szl0834/DIY-Optical-Spectrometer/FYP_Code/FYP/Data/a.jpg

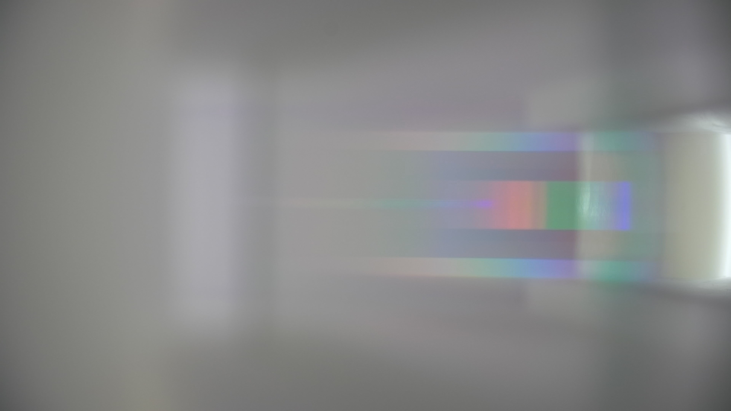
FYP_Code/FYP/Data/a.jpg
