szl0834/DIY-Optical-Spectrometer/README.md

# DIY-Optical-Spectrometer
A low cost high quality DIY optical spectrometer solution
