szl0834/DIY-Optical-Spectrometer/Presentation/Pre_Presentation.pptx

UESTC ID:
GUID:

## USB Spectrometer

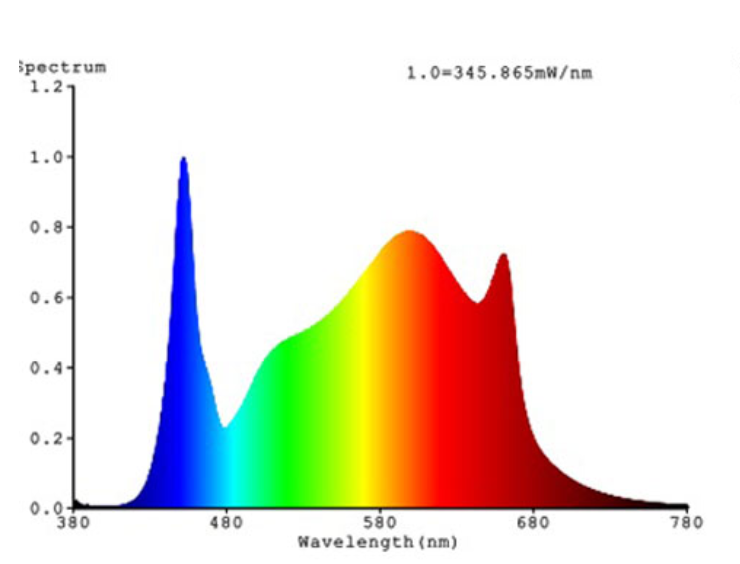
[picture p2: figure]
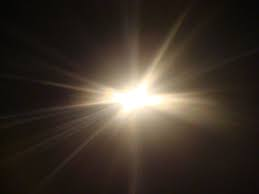
[picture p3: figure]

FT

## Structure of the spectrometer

Diffraction Grating

Source

Single Slit

USB Camera

## Diffraction Grating

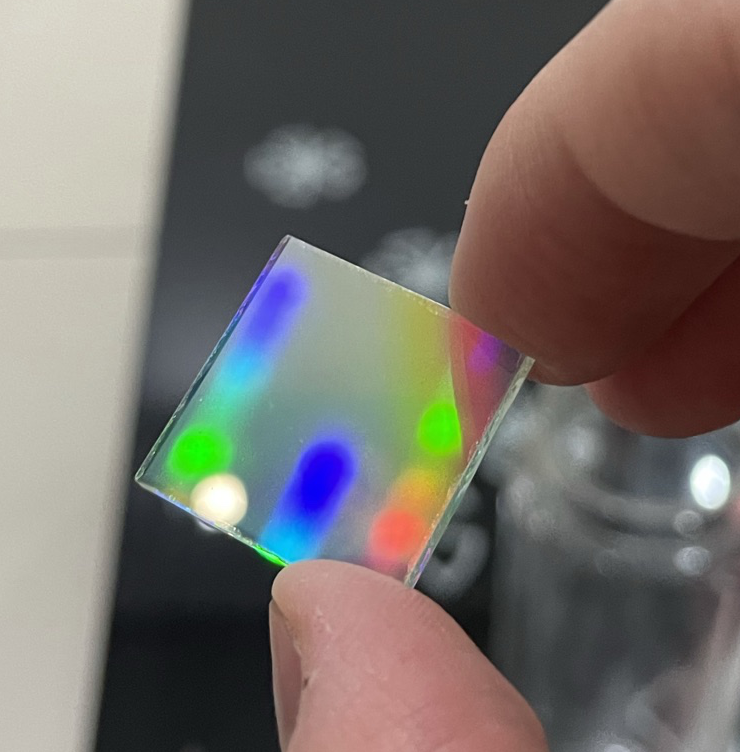
[picture p4: figure]
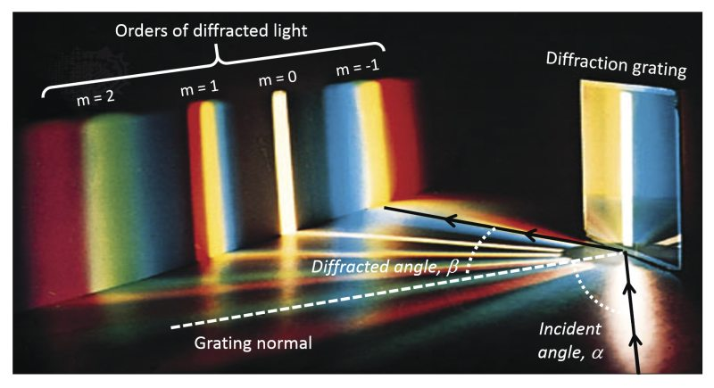
[picture p5: figure]
Diffraction Grating Physics
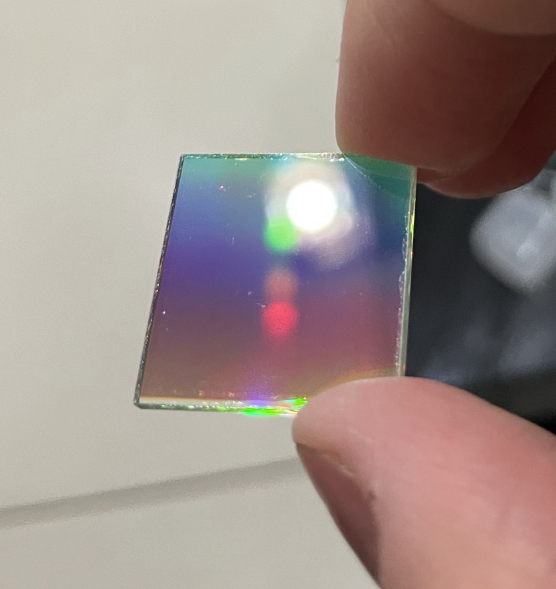
[picture p6: figure]

## Diffraction Grating

Combination of multi-split interference and single-split diffraction

d(sin(θ_i )−sin(θ_m ))=mλ

θ_m =arcsin(sin(θ_i )−(mλ)/d)

## Hardware Demo

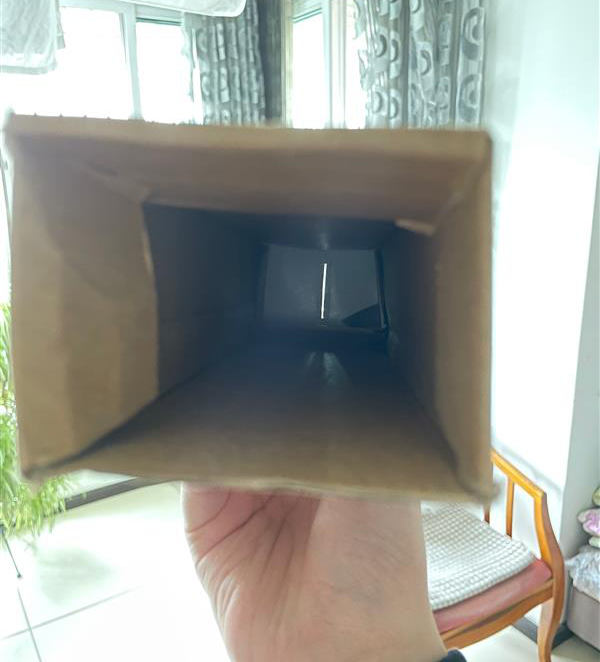
[picture p7: figure]
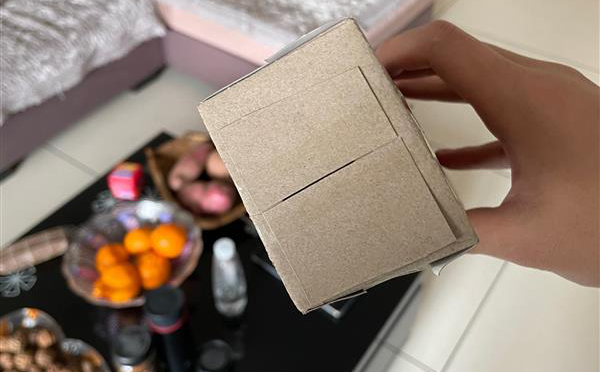
[picture p8: figure]
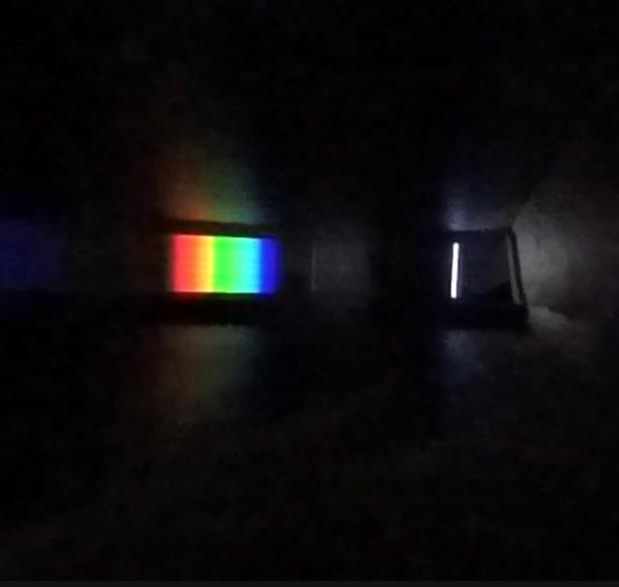
[picture p9: figure]
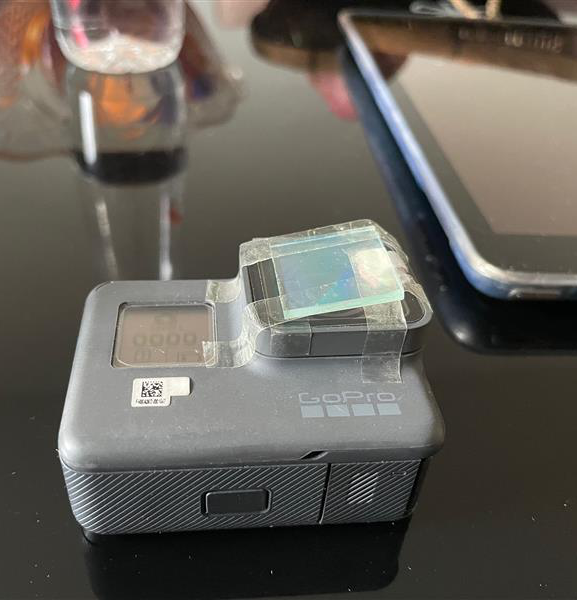
[picture p10: figure]

## Software Demo

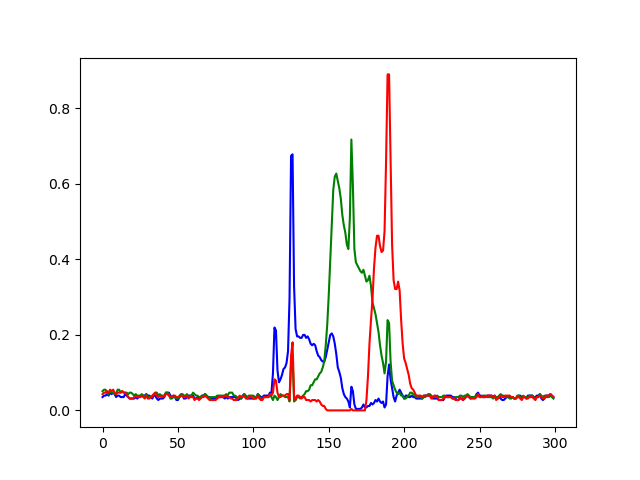
[picture p11: figure]

Using following open-source tools

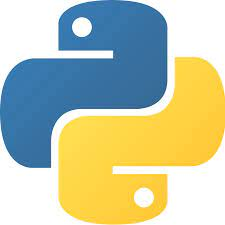
[picture p12: figure]
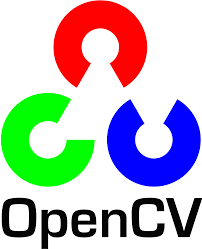
[picture p13: figure]
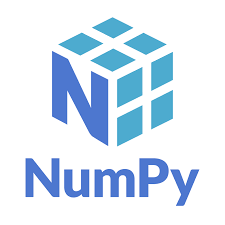
[picture p14: figure]
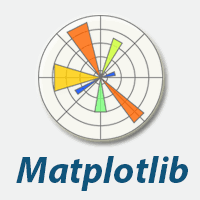
[picture p15: figure]

## Luminance Calibration

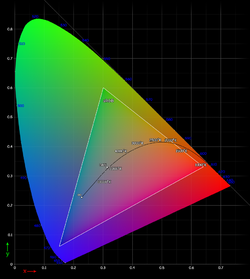
[picture p16: figure]
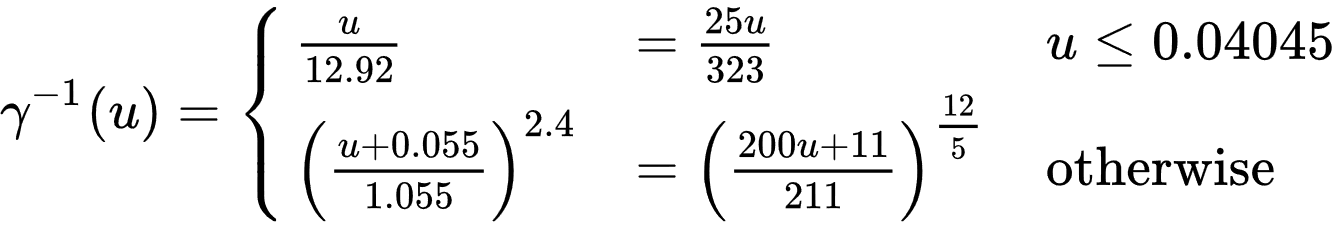
[picture p17: figure]

Where u is RGB in SRGB

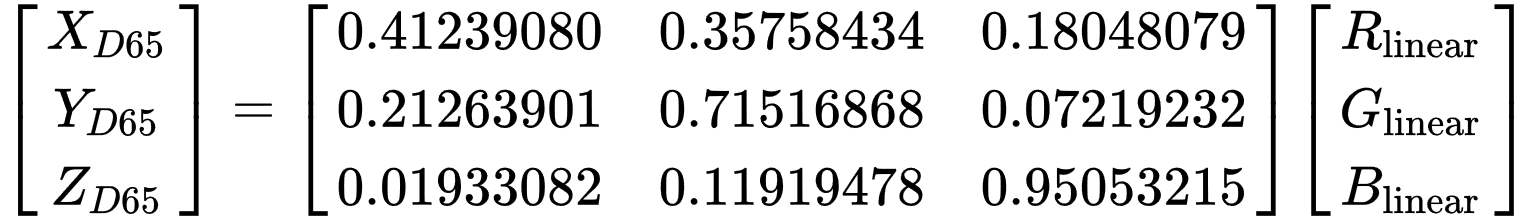
[picture p18: figure]

The Value Y is the relatively luminance

## Luminance Calibration

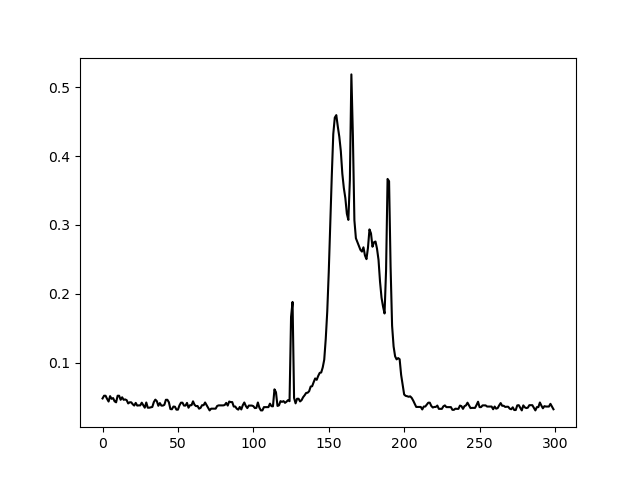
[picture p19: figure]

## Work to be done...

1. Mapping the X-axis to wavelength
2. Made an easy-to-use GUI
