szl0834/DIY-Optical-Spectrometer/Presentation/UESTC4006P_Presentation.pdf

# USB Spectrometer

Name:
UoG ID:
UESTC ID:

## My Student ID

## Index

- Background
- Hardware Design
- Software Design
- Building
- Demonstration
- Result
- Conclusion

## Background

- Absorption and Emission Spectrum
- Spectroscopy

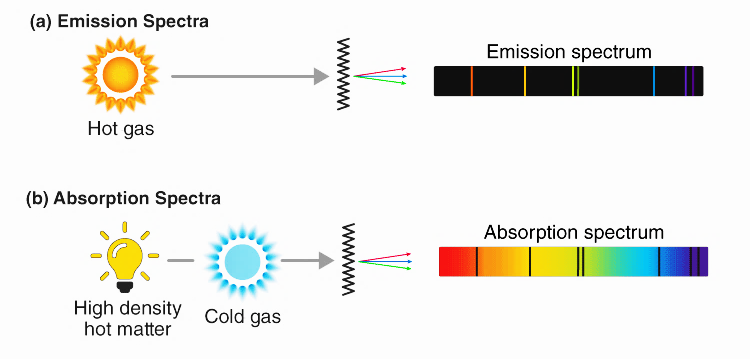
[picture p20: figure]

## Background

- Application
- Spectroscopy

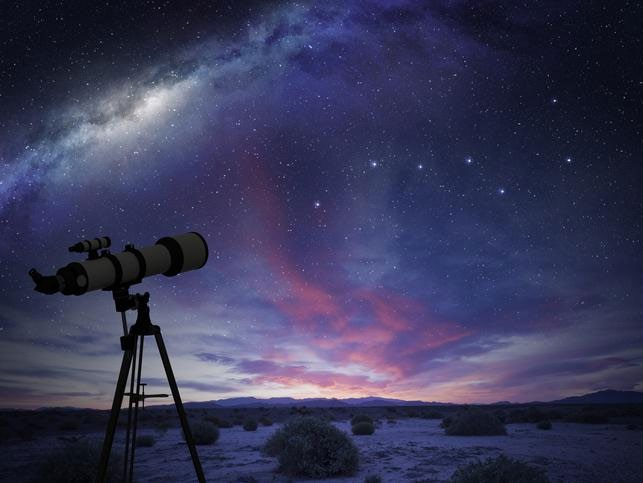
[picture p21: figure]
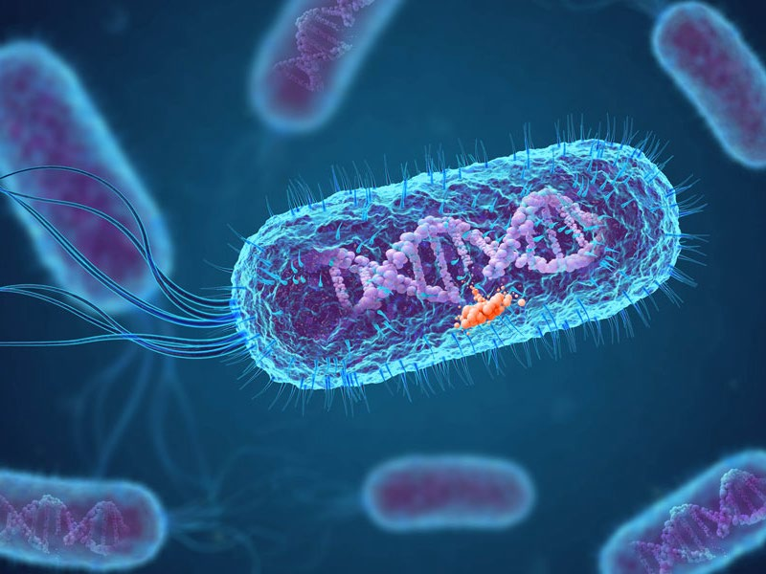
[picture p22: figure]
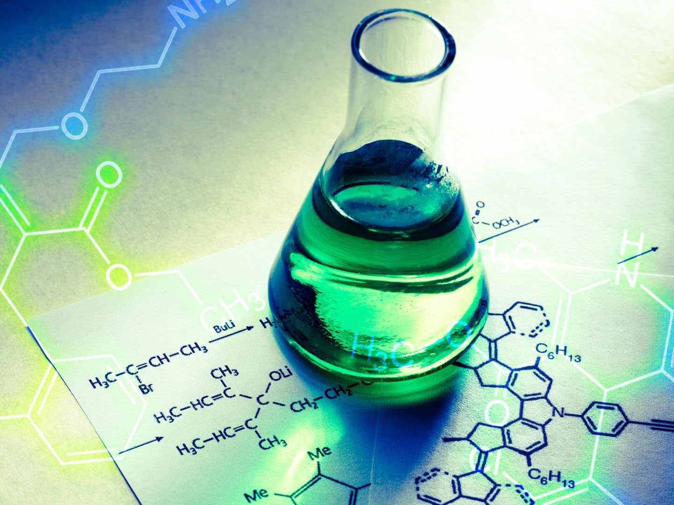
[picture p23: figure]

Chemistry | Astronomy | Biology

## Background

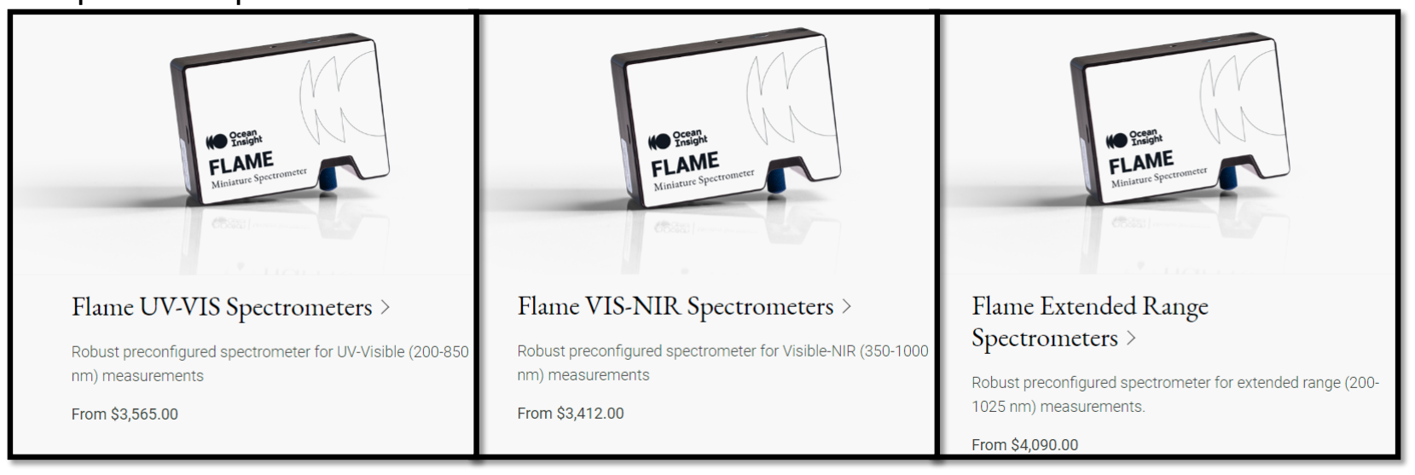
[picture p24: figure]

- Commercial Solution:
Extremely High Price (Thousands of Dollars)
- Optical Spectrometer

## Background

- Current DIY Solution
- Optical Spectrometer
- Low Cost
- Low Resolution
- Low Accuracy
- No Compatible Software

## Background

- Design Goal
- Optical Spectrometer
- Less than 1 nm resolution
- Wide Wavelength Range (400-1000 nm)
- Less than 2000 CNY of cost
- Easy-to-use software
- Opensource all code, 3D models, and other material

## Hardware Design

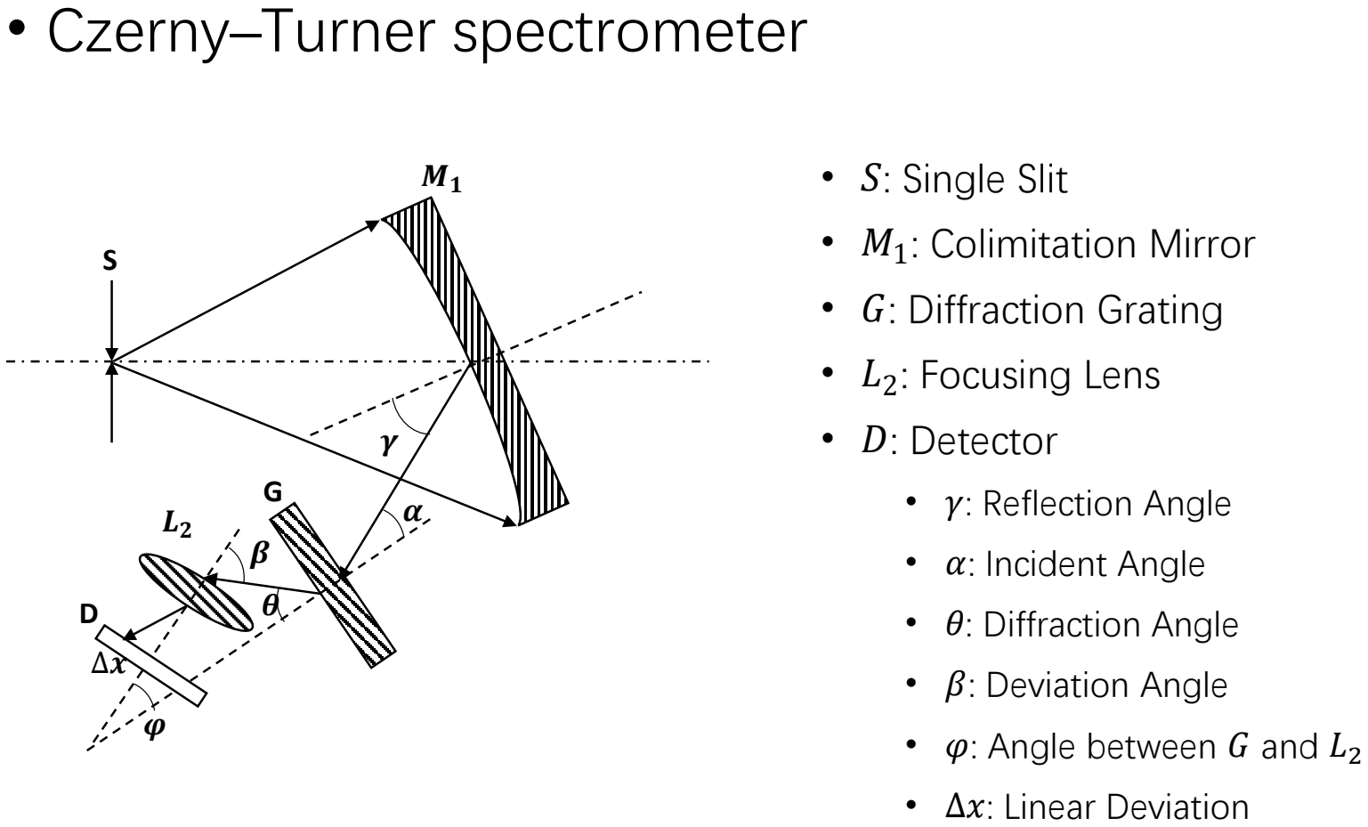
[picture p25: figure]
• Czerny–Turner spectrometer; • SS: Single Slit • MM1: Colimitation Mirror • GG: Diffraction Grating • LL2: Focusing Lens • DD: Detector; • γγ: Reflection Angle • αα: Incident Angle • θθ: Diffraction Angle • ββ: Deviation Angle • φφ: Angle between GG and LL2 • ∆xx: Linear Deviation

## Hardware Design

- Diffraction Grating

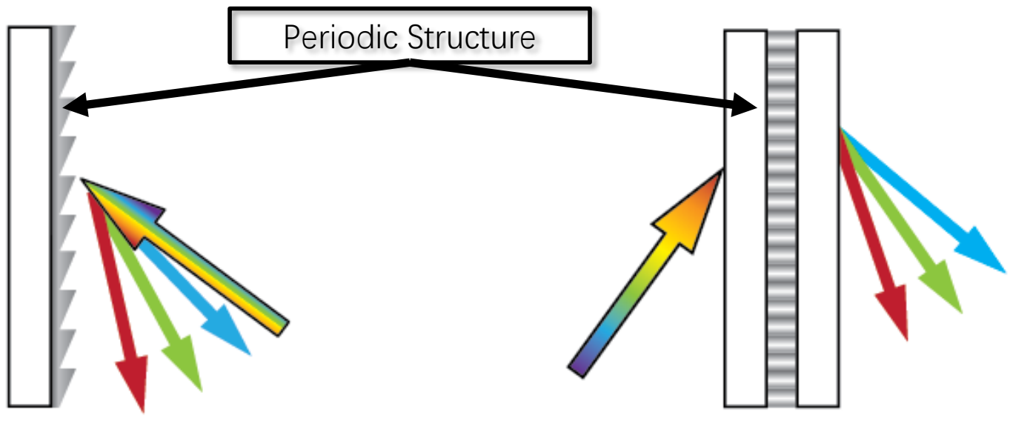
[picture p26: figure]
Periodic Structure

Reflected Grating [1] | Transparent Grating [1]

## Hardware Design

- Diffraction Grating

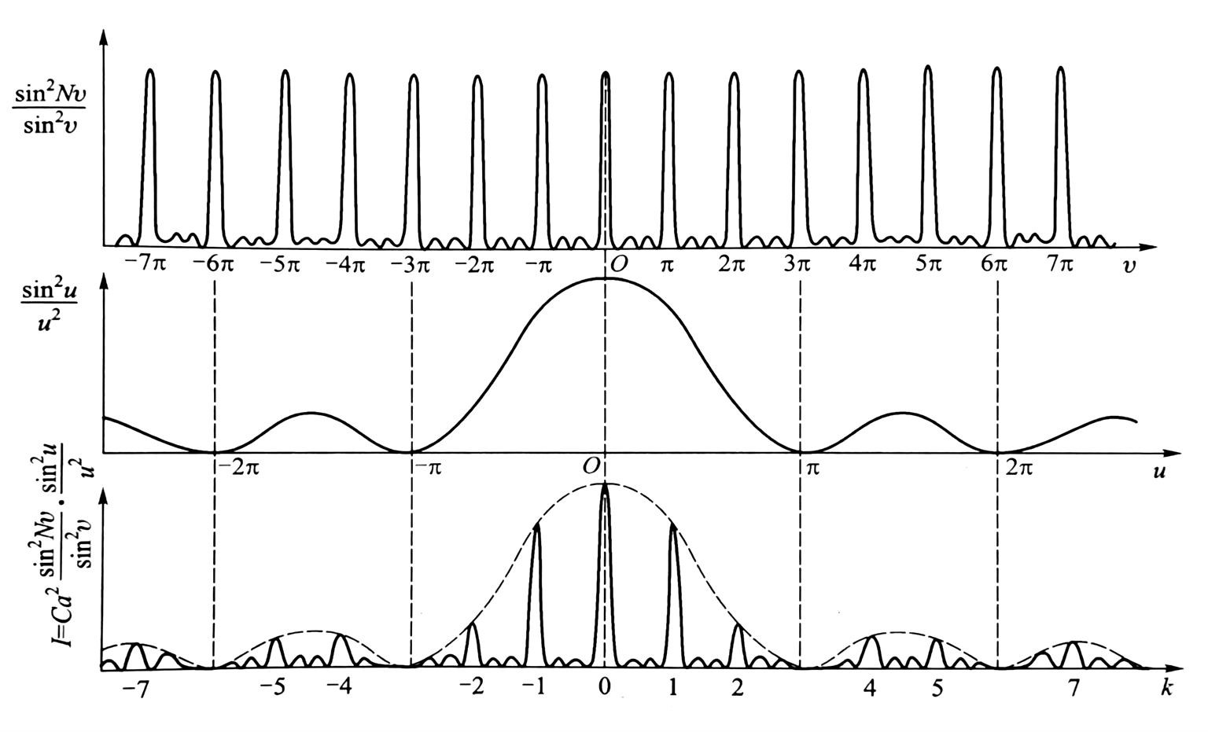
[picture p27: figure]

# II = AA2 = CC′2

# aa2 ssssss2 uu

uu2

# ssssss2 NNNN

ssssss2
Where uu =

# ππππππππππππ

# λλ , and = ππ +bb

λλ .

# Grating Equation: dd ssssss ± ssssss = kkkk

## Hardware Design

- System Resolution
- Imaging resolution caused by the aperture diffraction limit
- Chromatic resolution of the grating
- The width of the slit’s image on the sensor
- Sensor’s physical resolution.

## Hardware Design

- Grating Chromatic Resolution

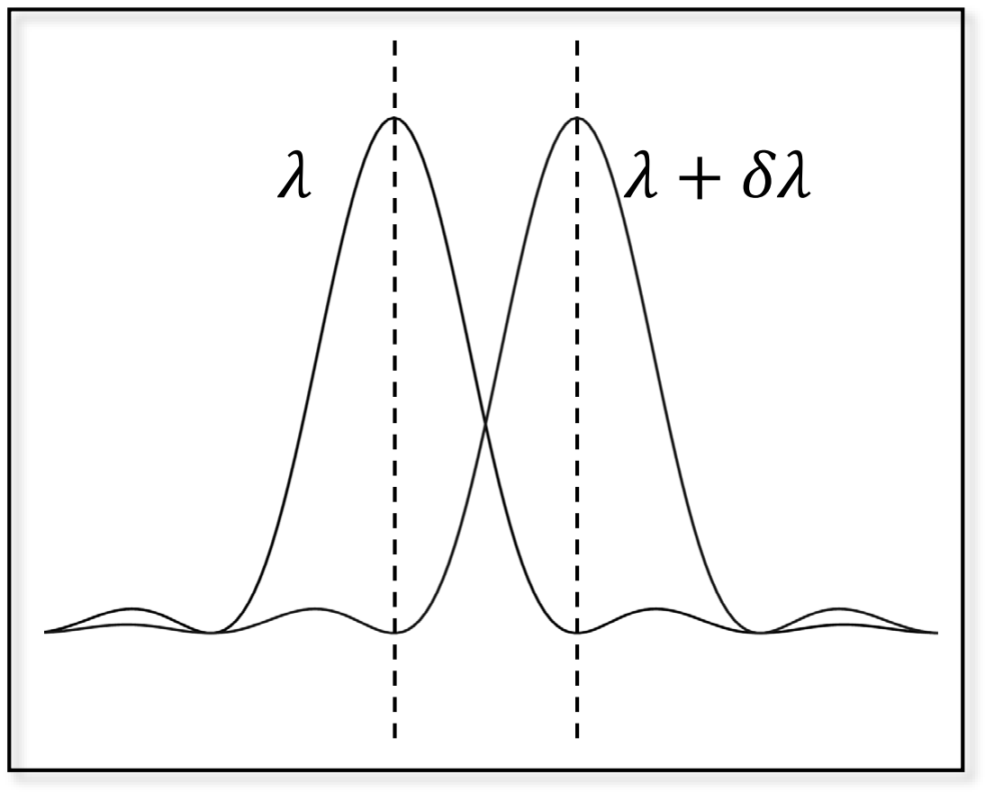
[picture p28: figure]

RR =
δδ

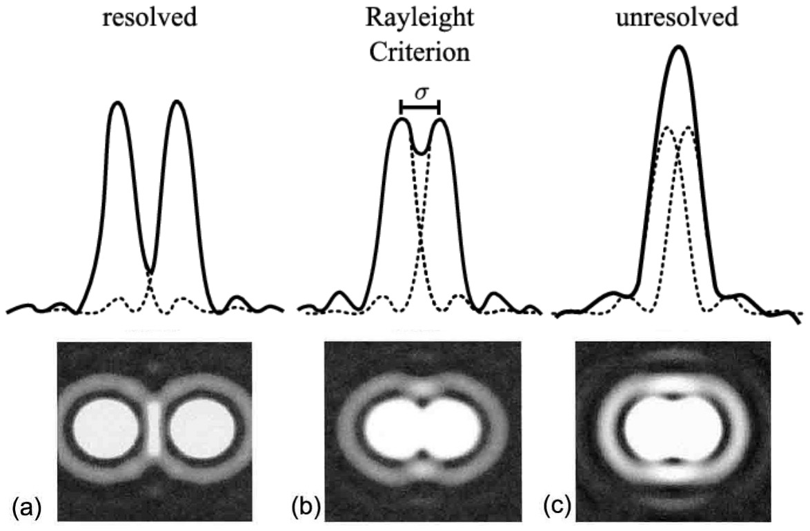
[picture p29: figure]

Demonstration for Rayleigh | = NN − 1 ≈ NN Criterion [4]

## Hardware Design

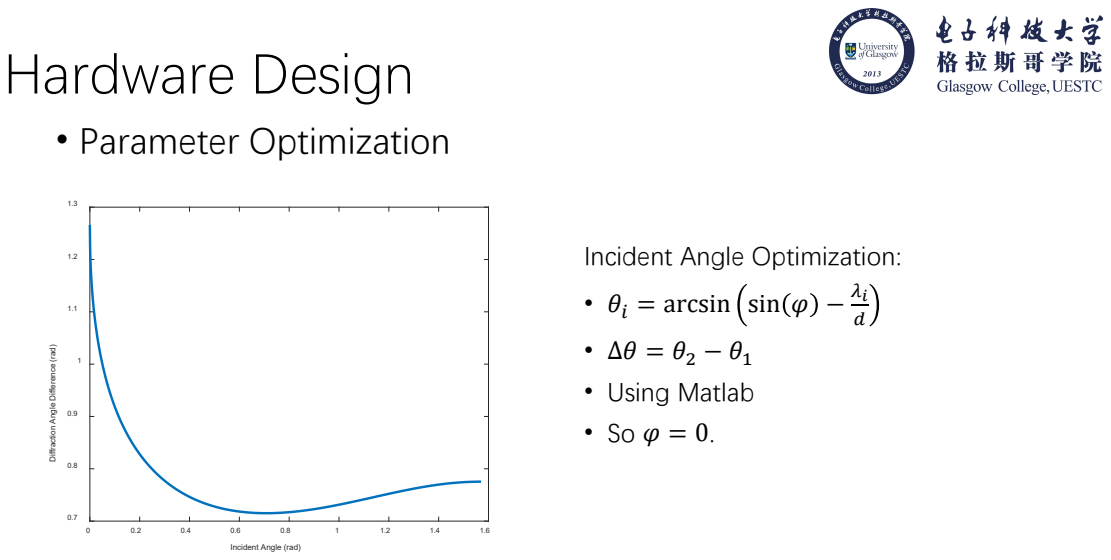
[picture p30: page 14]
• Parameter Optimization

• θθ = arcsin sin φφ − λλii
Incident Angle Optimization:
• Using Matlab

Diffraction Angle Difference (rad)

Incident Angle (rad)

## Hardware Design

- Computer Simulation

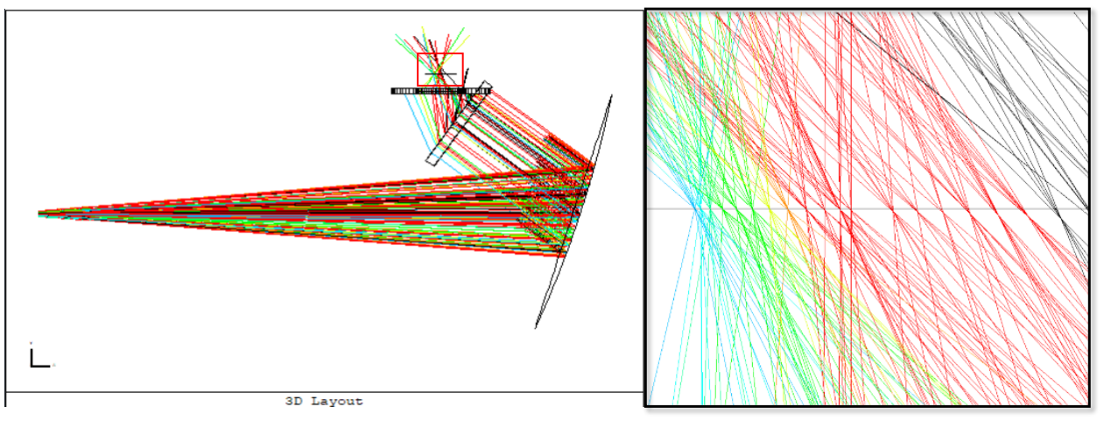
[picture p31: figure]

- Optical Simulation Software: Zemax Optical Studio

## Hardware Design

- Computer Simulation

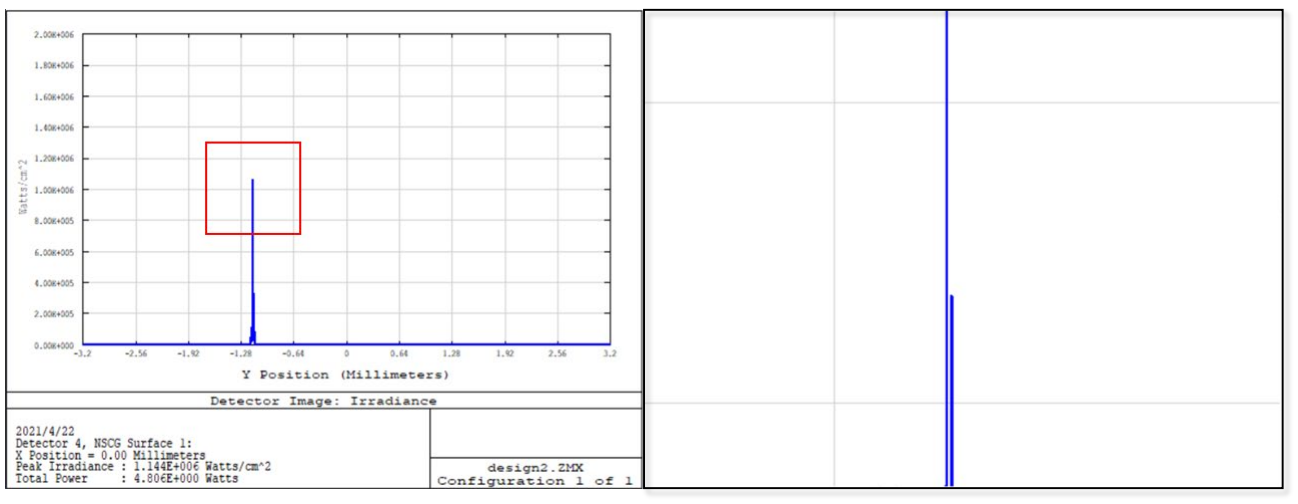
[picture p32: figure]

- D-lines of Sodium (588.9 and 589.5 nm)

# - RRRR RRRR RR RR < 0.6 nn < 1 nn

## Hardware Design

- Computer Simulation

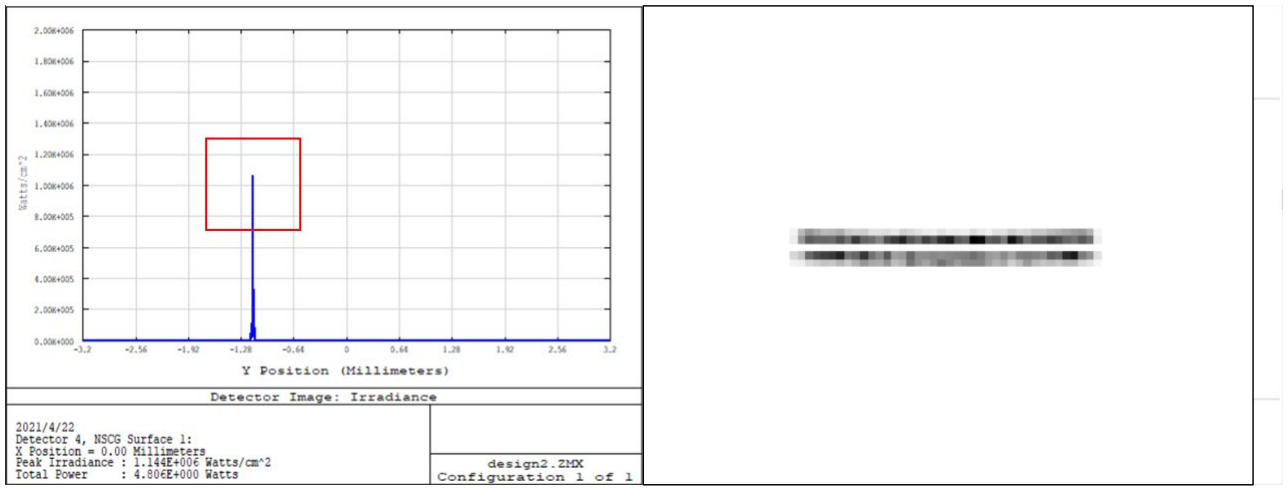
[picture p33: figure]

- D-lines of Sodium (588.9 and 589.5 nm)

## Software Design

- Linear Dispersion

= dd ∗

# ssssss + sin ∆xx

FFLL2

− φφ
kk

Using Imaging Formula and Grating Equation:
∆xx

Spectra Line of
Wavelength Light

## Software Design

- Linear Calibration
Wavelength ( ) | (PPPP) Pixel Position (start from zero)
532 nm | 827
808 nm | 1919
632.8 nm | 1179
650 nm | 1289
3 lasers’ spectrum | Recorded Data

## Software Design

- Color Space

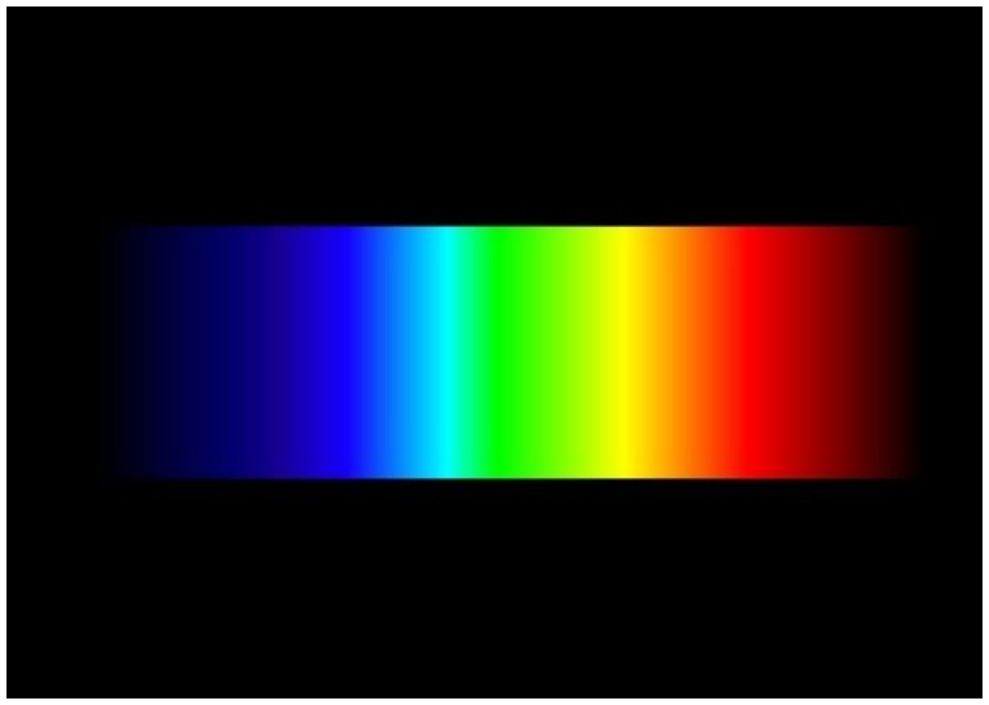
[picture p34: figure]

Continuous Spectrum

Mapping

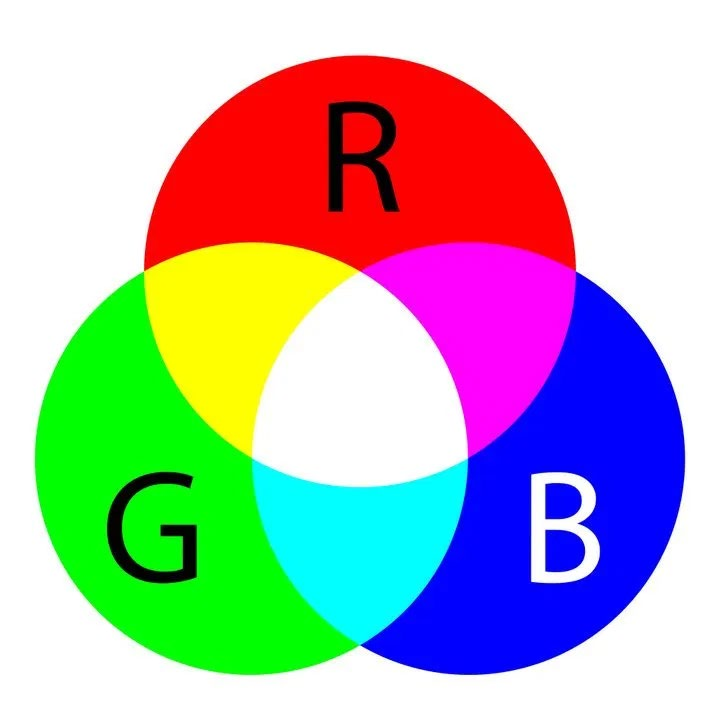
[picture p35: figure]

RGB Color Space

## Software Design

- sRGB Color Space

standard Red Green Blue (sRGB): Design to match perceptions of human eyes

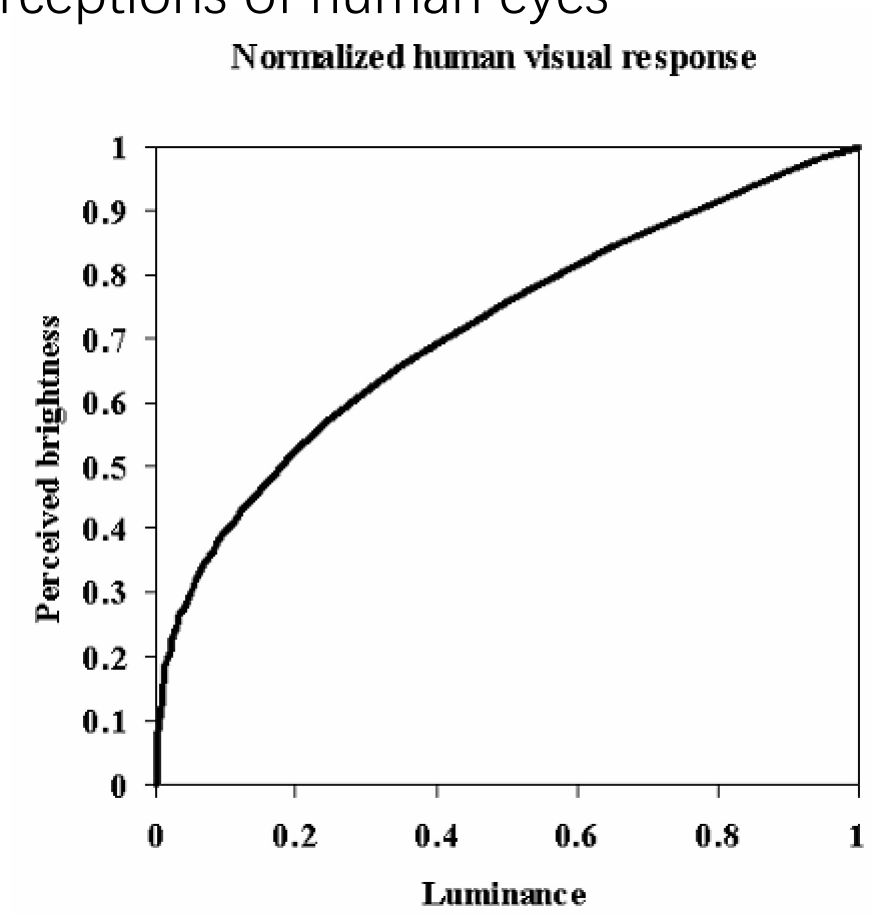
[picture p36: figure]
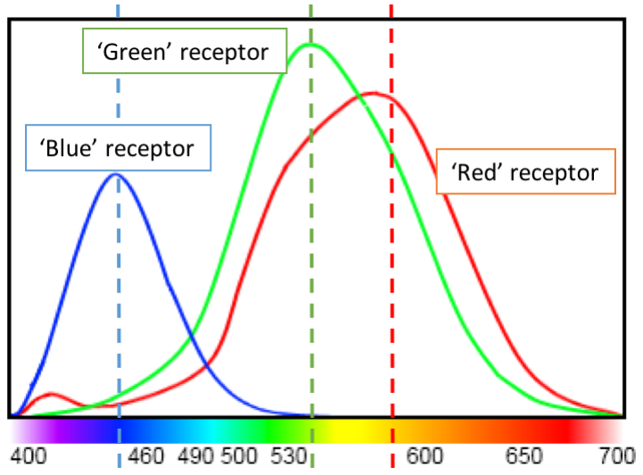
[picture p37: figure]

Sensitivity of Human Eyes [2] | Human Visual Brightness Response [3]

## Software Design

- CIE 1931 Color Space

## γγ−1 uu

25uu
323 , uu ≤ 0.04045
200uu + 11
211

12
5

# ， o oooo

XX
YY
ZZ

=

0.4124 0.3576 0.1805
0.2126 0.7152 0.0722
0.0193 0.1192 0.9505

# Rl l l Gl l l Bl l l

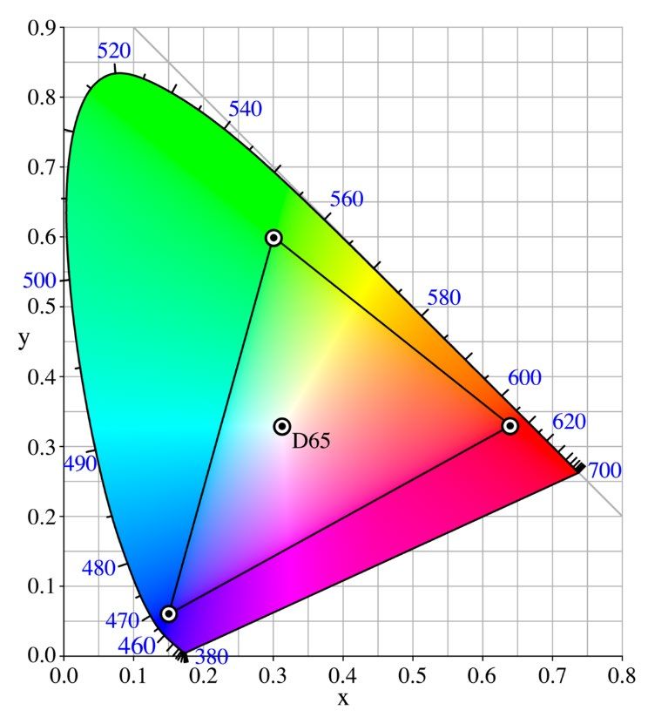
[picture p38: figure]

Chromatic Graph of CIE 1931 [5]

# YY = RRRRRR RR RR LL LL

## Software Design

- Python3 and Opensource Libraries

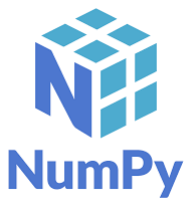
[picture p39: figure]
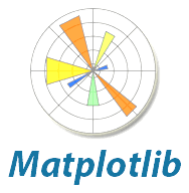
[picture p40: figure]
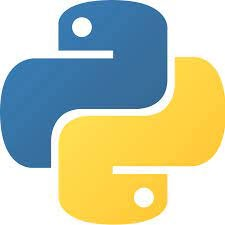
[picture p41: figure]
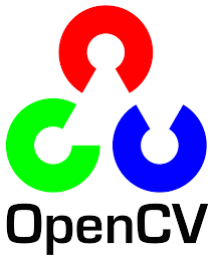
[picture p42: figure]

## Hardware Building

- 3D Modeling

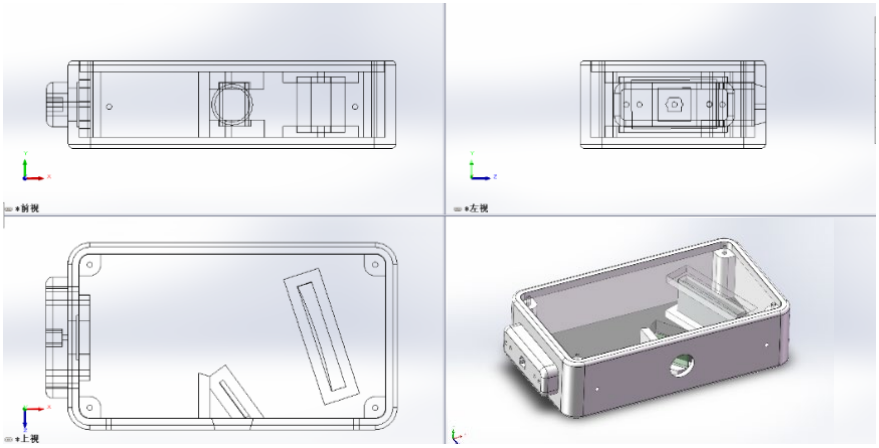
[picture p43: figure]

## Hardware Building

- 3D Printing

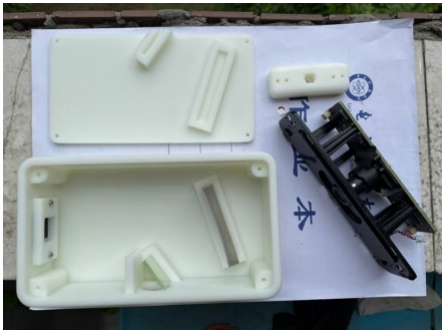
[picture p44: figure]

## Hardware Building

- Assembling

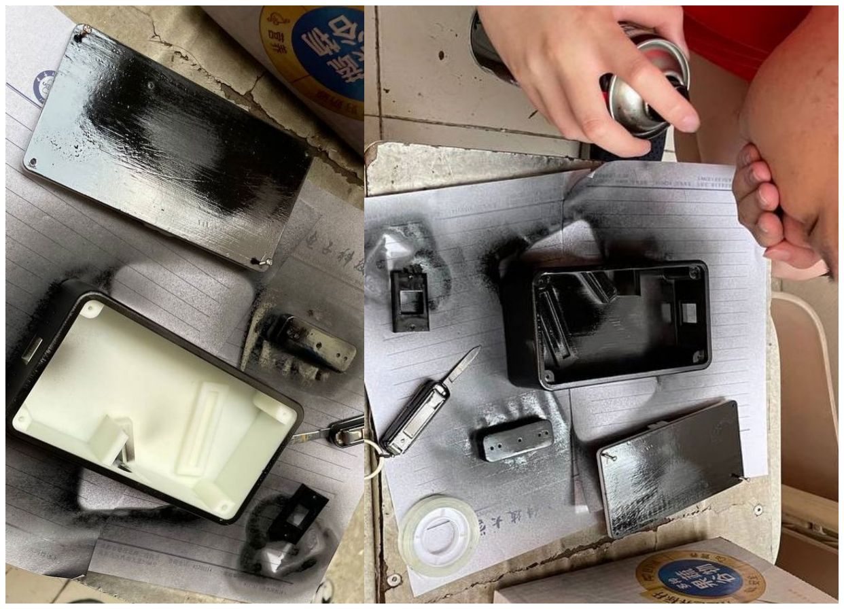
[picture p45: figure]
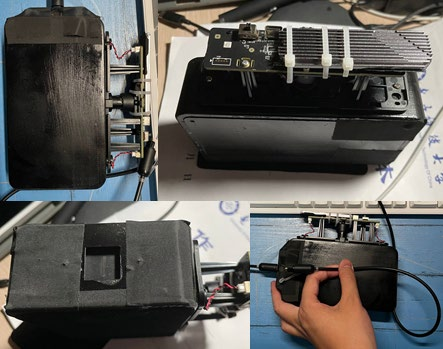
[picture p46: figure]
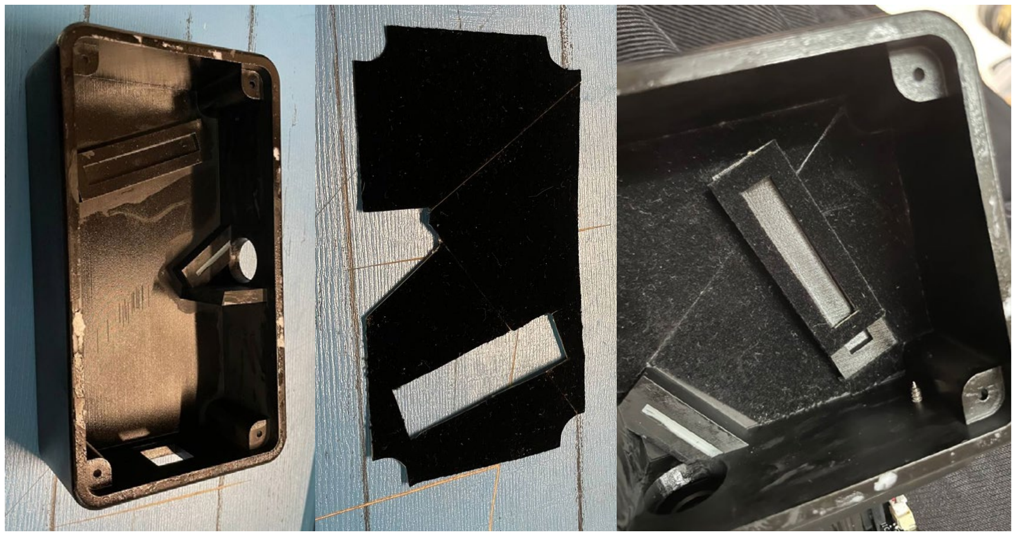
[picture p47: figure]

## Hardware Building

- Total Cost
Name of component | Price with shipping fee (CNY)
Diffraction Grating | 165
Collimator Mirror | 105
Steel Single Slit | 125
Camera | 499
3D Printed Case | 285
Optical Fibre | 20
Lasers | 70
Overall | 1269

## Demonstration

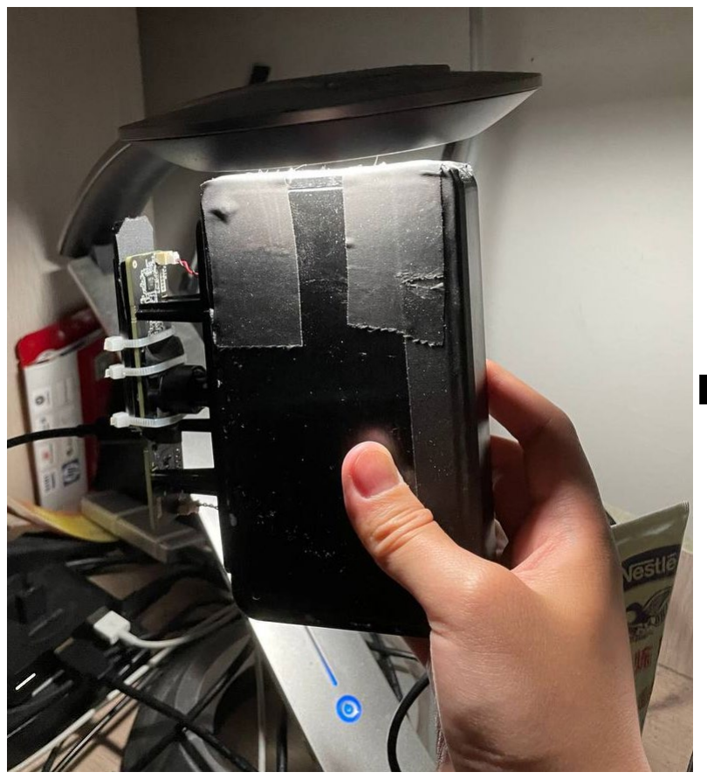
[picture p48: figure]
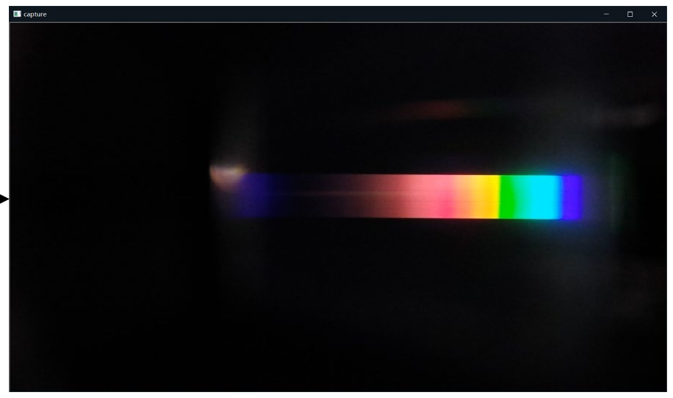
[picture p49: figure]
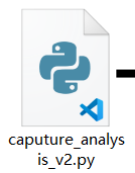
[picture p50: figure]
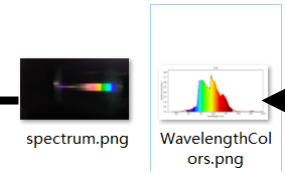
[picture p51: figure]
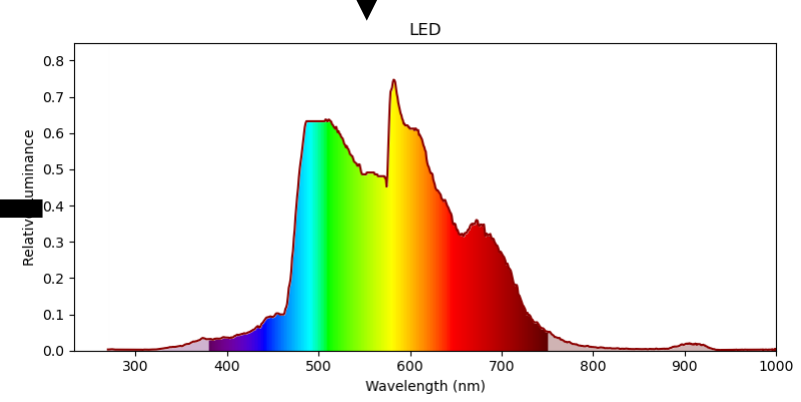
[picture p52: figure]

## Result

- Measurement of Different Light Source
- 3 type of Laser, Mercury Lamp, Sodium Lamp, etc.

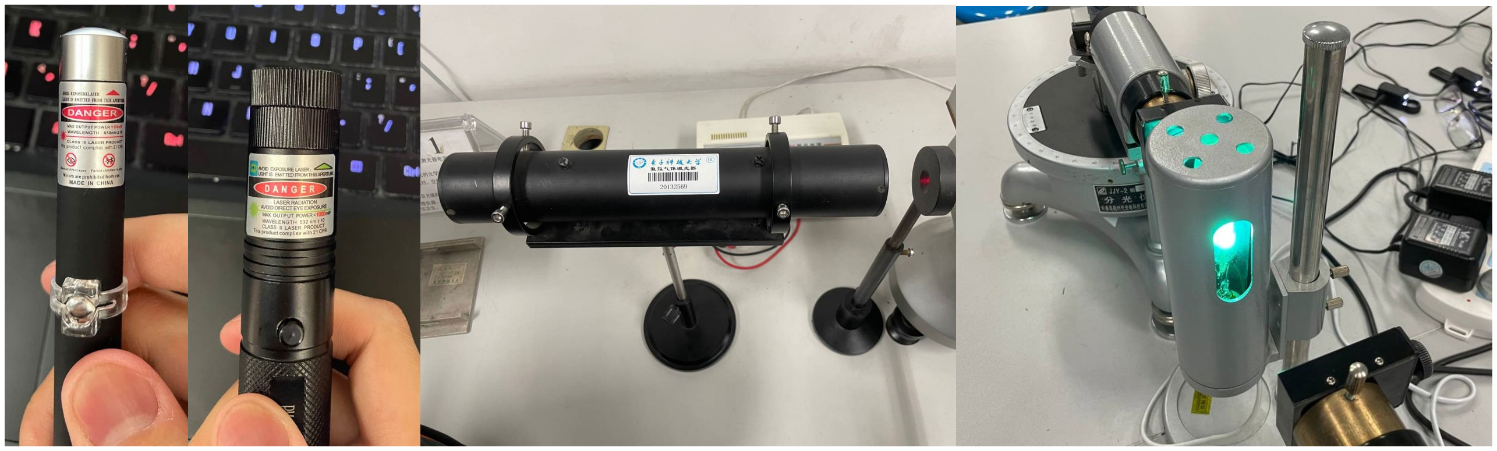
[picture p53: figure]

## Result

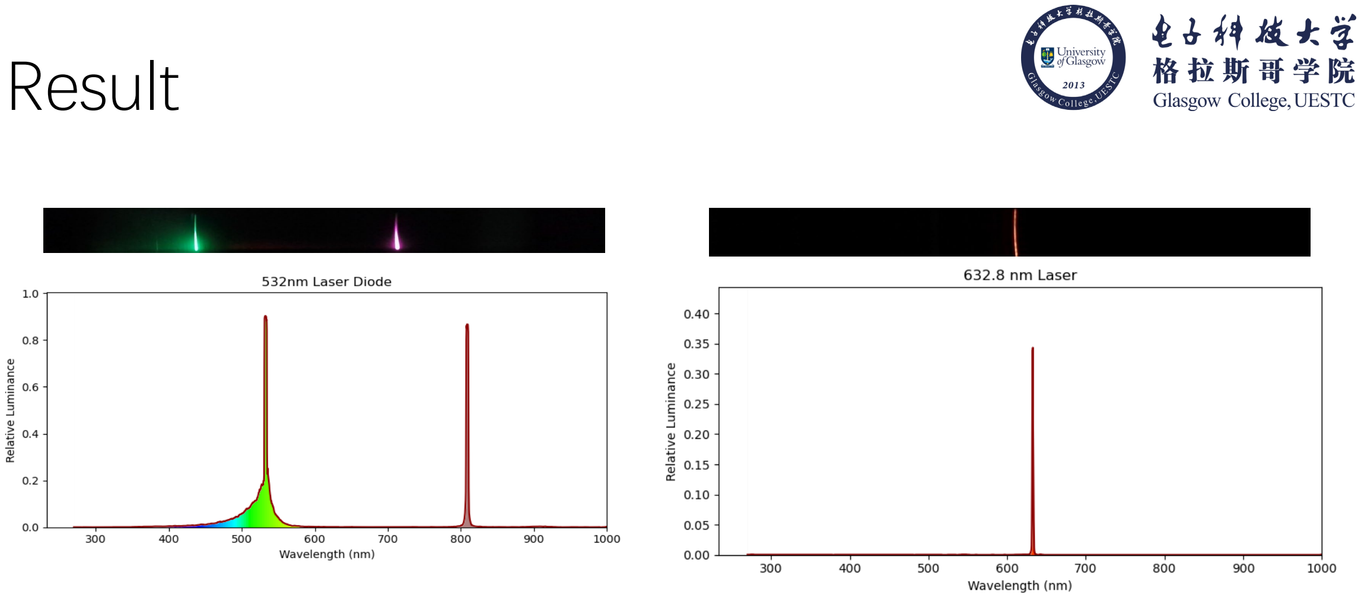
[picture p54: page 30]

## Result

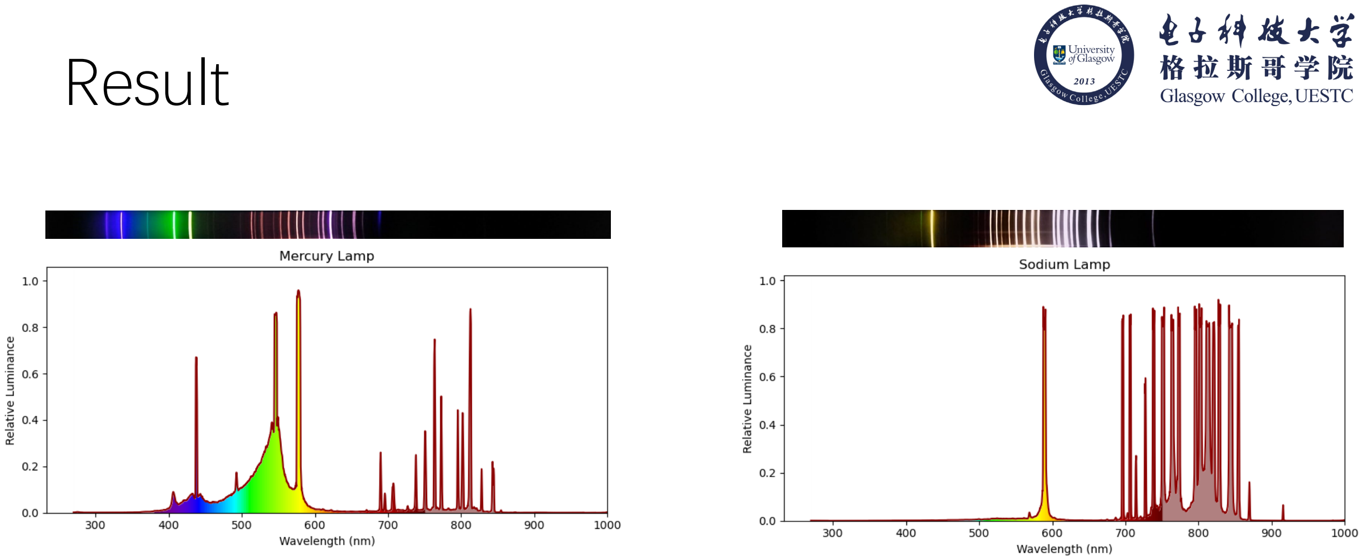
[picture p55: page 31]

## Result

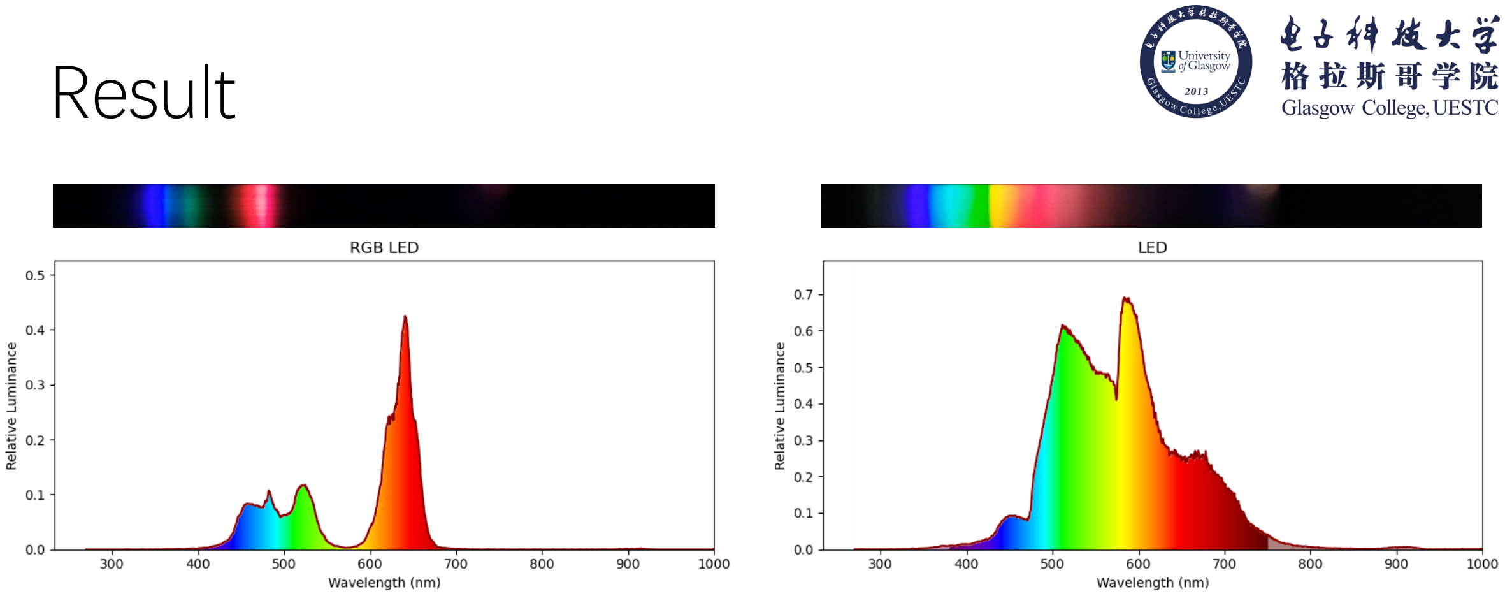
[picture p56: page 32]

## Result

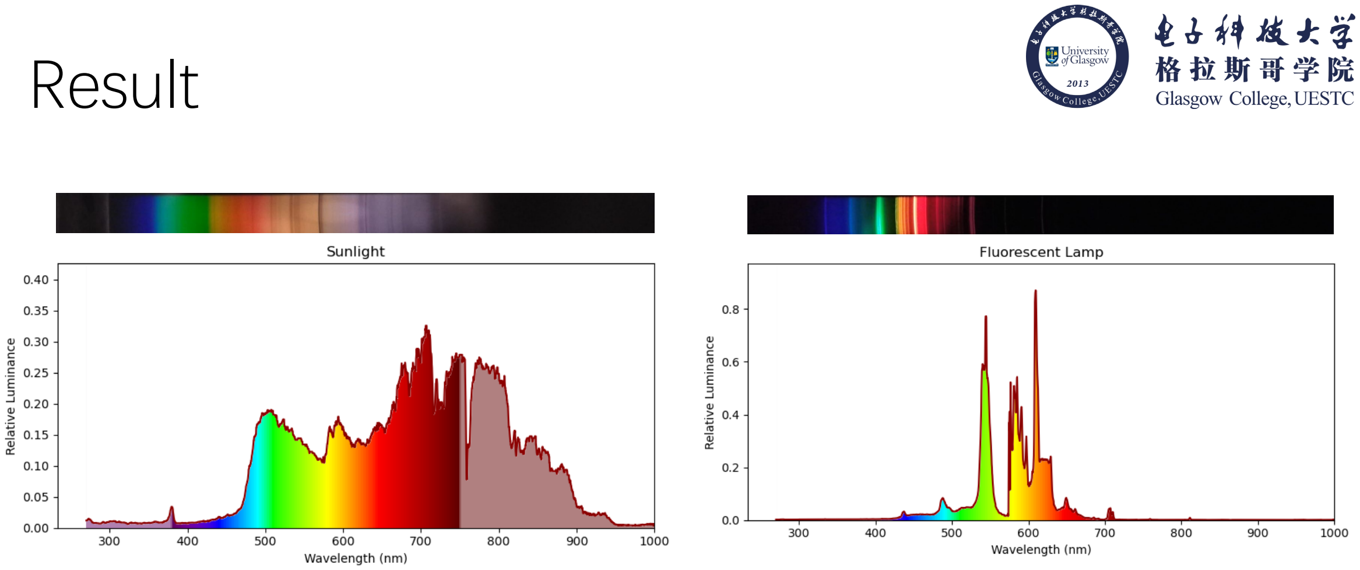
[picture p57: page 33]

## Result

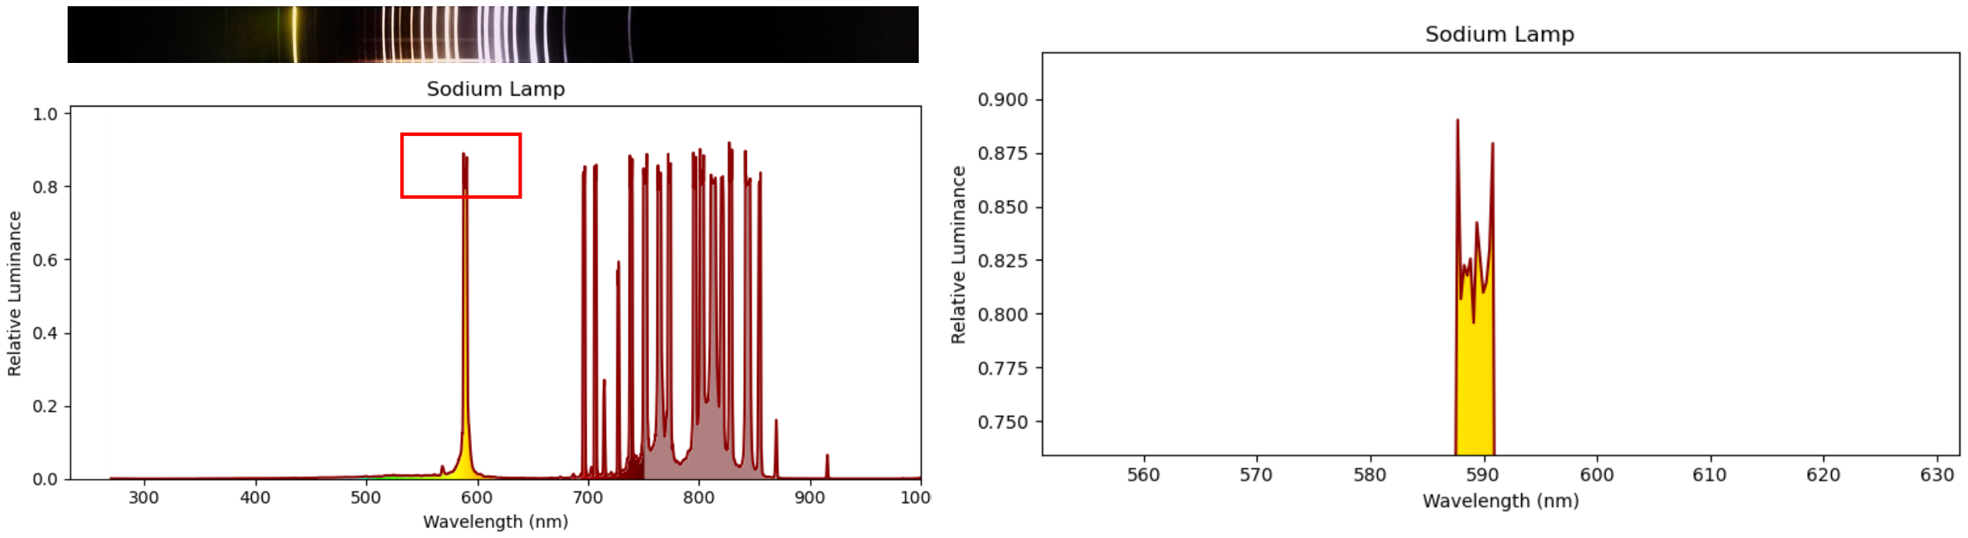
[picture p58: figure]

- D-lines of Sodium (588.9 and 589.5 nm)

# - RRRR RRRR RR RR < 0.6 nn < 1 nn

## Conclusion

- The spectrometer achieves the 0.6 nm resolution
- The total cost is about 1200 CNY
- The wavelength range is around 350-950 nm
- An easy-to-use software is built.
- All the material is open-sourced in my Github Repository: https://github.com/szl0834

In conclusion, the project satisfied the design goals.

## Future Works

- Using standard luminance light source as the reference to mapping the relative luminance to the physical luminous flux value.

## Reference

[1] Wasatch Photonics., "What Are the Types of Diffraction Gratings?," [Online]. Available: | https://wasatchphotonics.com/technologies/types-diffraction-gratings/. [Accessed 7 5 2021].
[2] C. Zhang, S. Ashwinlal and J. Comins, "Spectral Ray Tracing," [Online]. Available: | https://ceciliavision.github.io/graphics/a6/. [Accessed 7 5 2021].
[3] "The Human Visual System," [Online]. Available: http://what-when-how.com/display- | interfaces/the-human-visual-system-display-interfaces-part-1/. [Accessed 7 5 2021].
[4]D. Tim, "Tomographic reconstruction of combined tilt- and focal series in scanning | transmission electron microscopy," ResearchGate, 1 2015.
[5]BenRG, "CIE 1931 xy color space diagram," 24 09 2009. [Online]. Available: | https://commons.wikimedia.org/wiki/File:CIExy1931.png. [Accessed 20 04 2021].

# Thanks for Listening
