szl0834/DIY-Optical-Spectrometer/Presentation/Meeting_ppt1.pptx

FT

## Slide 2

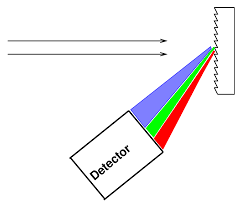
[picture p87: figure]

Diffraction Grating

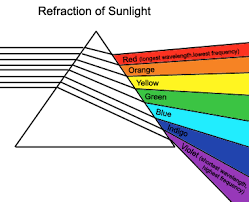
[picture p88: figure]

Prism

## Slide 3

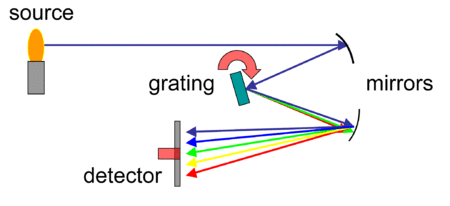
[picture p89: figure]
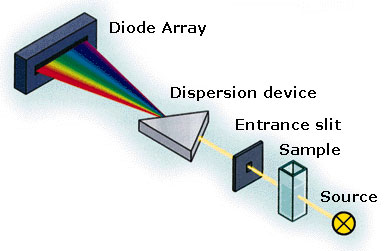
[picture p90: figure]
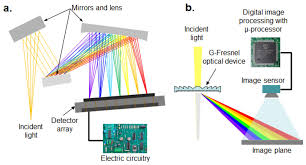
[picture p91: figure]
