szl0834/DIY-Optical-Spectrometer/Presentation/Meeting_ppt2.pptx

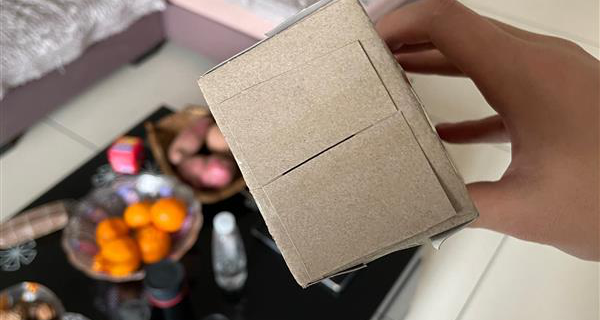
[picture p92: figure]
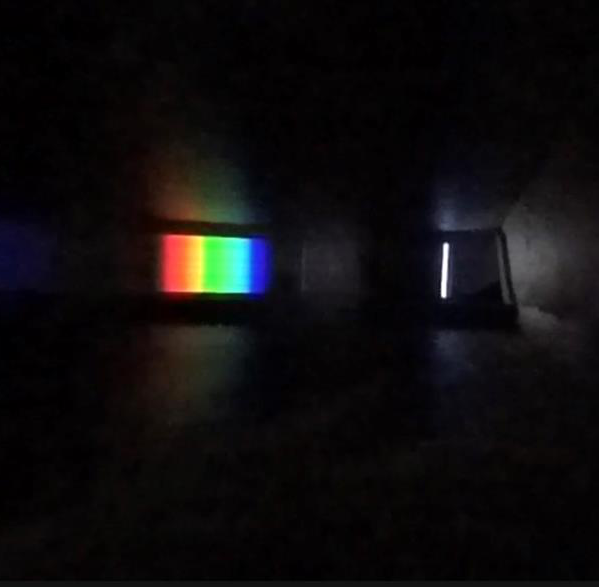
[picture p93: figure]
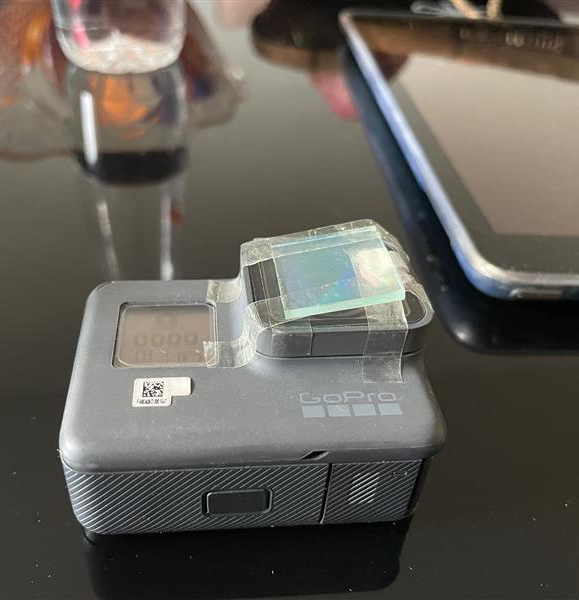
[picture p94: figure]
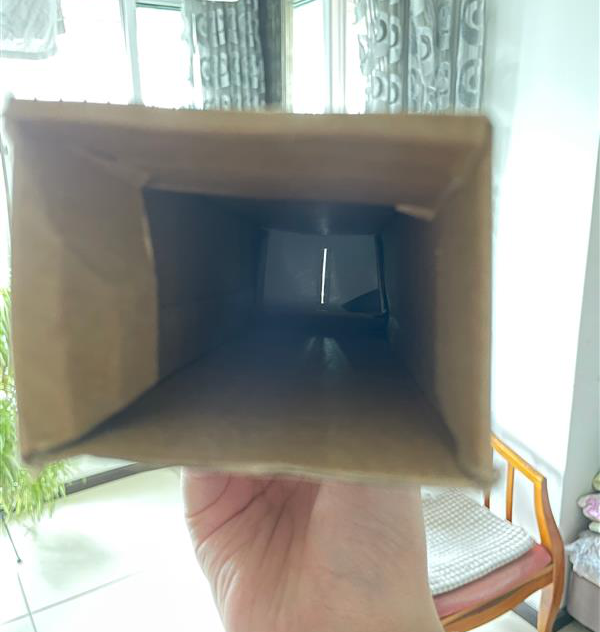
[picture p95: figure]

## Slide 2

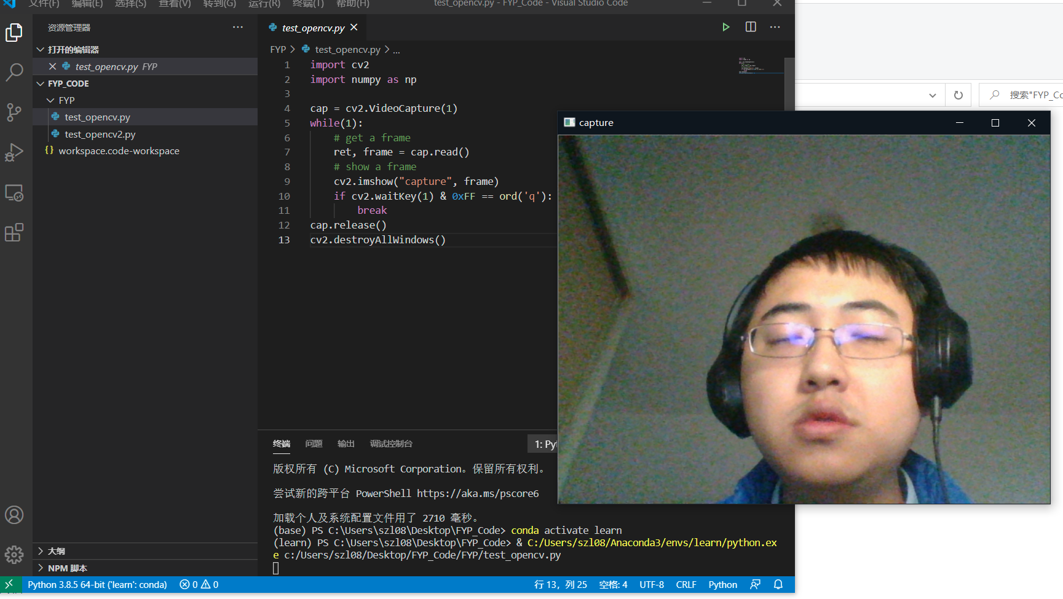
[picture p96: figure]
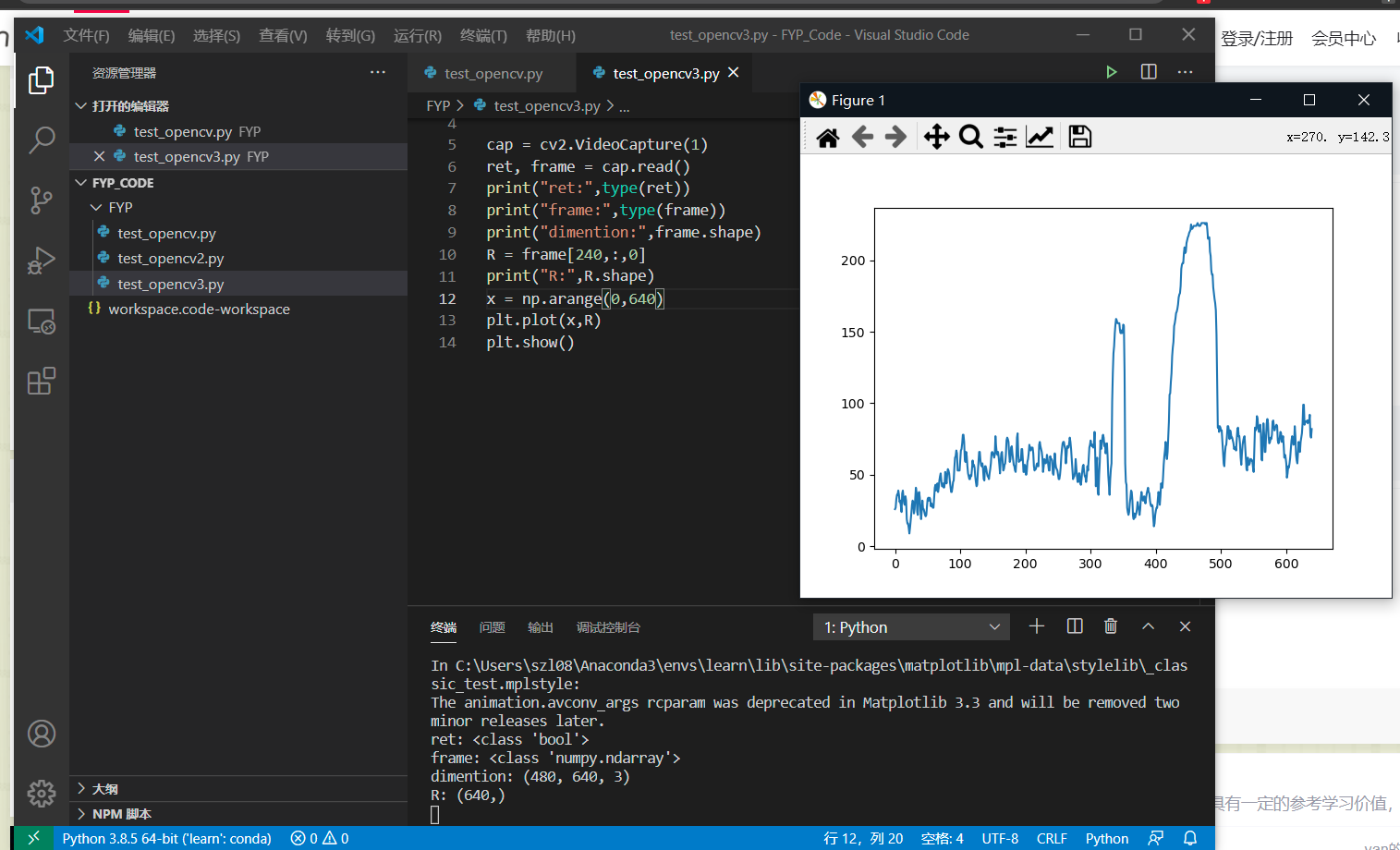
[picture p97: figure]
