szl0834/DIY-Optical-Spectrometer/Figure/532nm Laser Diode.png

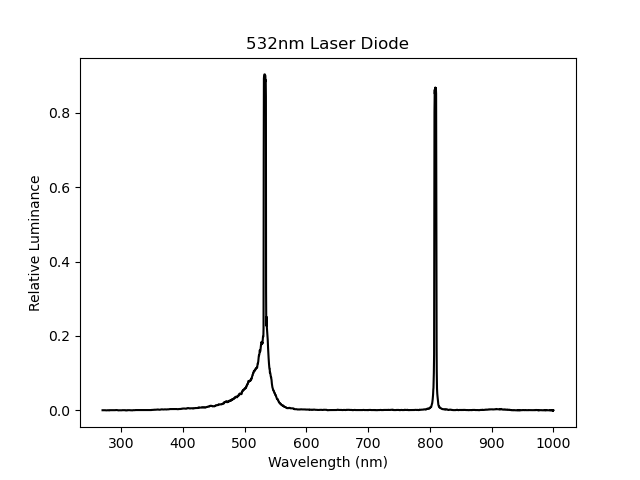
Figure/532nm Laser Diode.png
