szl0834/DIY-Optical-Spectrometer/Figure/632.8nm He-Ne Laser.png

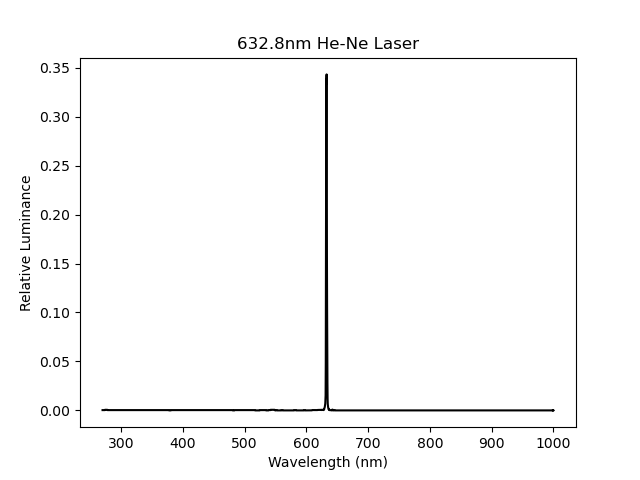
Figure/632.8nm He-Ne Laser.png
