szl0834/DIY-Optical-Spectrometer/Figure/Figure_3.png

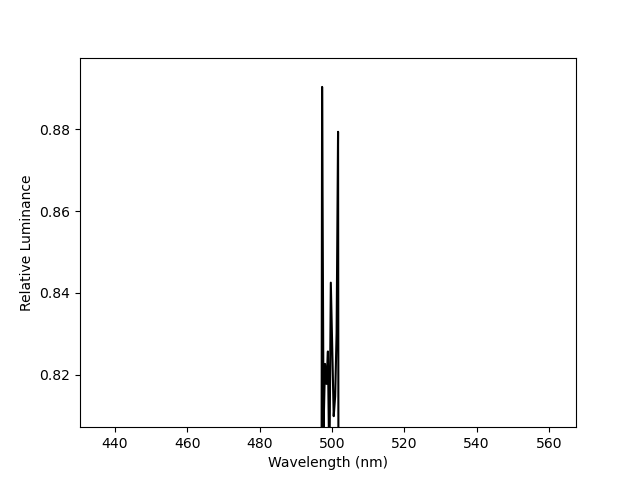
Figure/Figure_3.png
