szl0834/DIY-Optical-Spectrometer/Figure/Figure_4.png

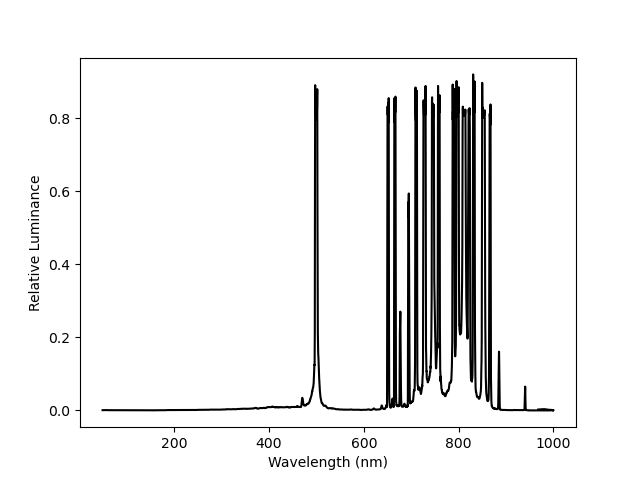
Figure/Figure_4.png
