szl0834/DIY-Optical-Spectrometer/Figure/Fluorescent Lamp.png

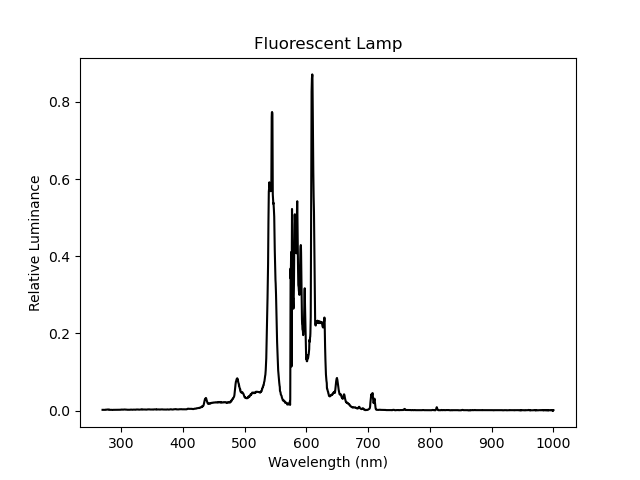
Figure/Fluorescent Lamp.png
