szl0834/DIY-Optical-Spectrometer/Figure/LED.png

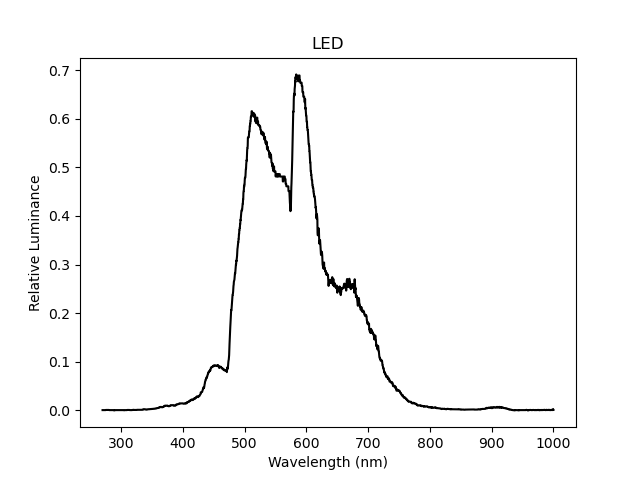
Figure/LED.png
