szl0834/DIY-Optical-Spectrometer/Figure/Mercury Lamp(Low Exposure)(Zoomed).png

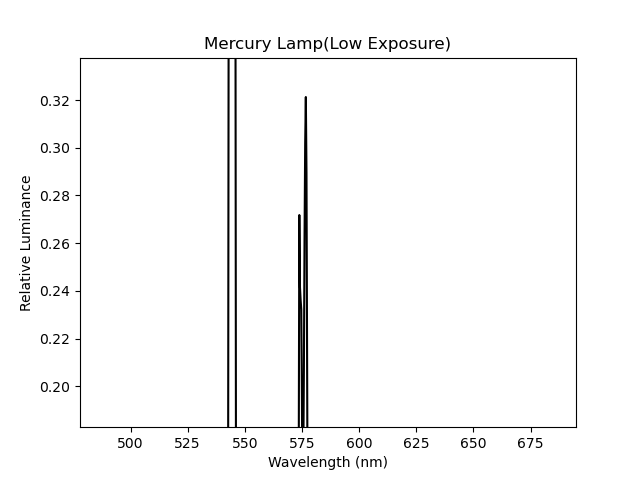
Figure/Mercury Lamp(Low Exposure)(Zoomed).png
