szl0834/DIY-Optical-Spectrometer/Figure/Mercury Lamp(Low Exposure).png

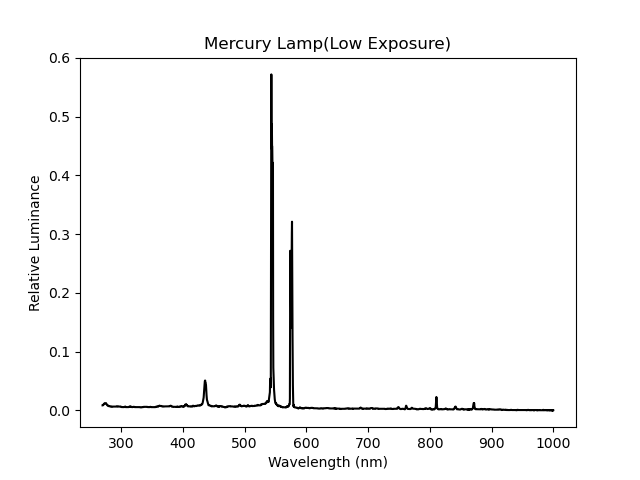
Figure/Mercury Lamp(Low Exposure).png
