szl0834/DIY-Optical-Spectrometer/Figure/Mercury Lamp.png

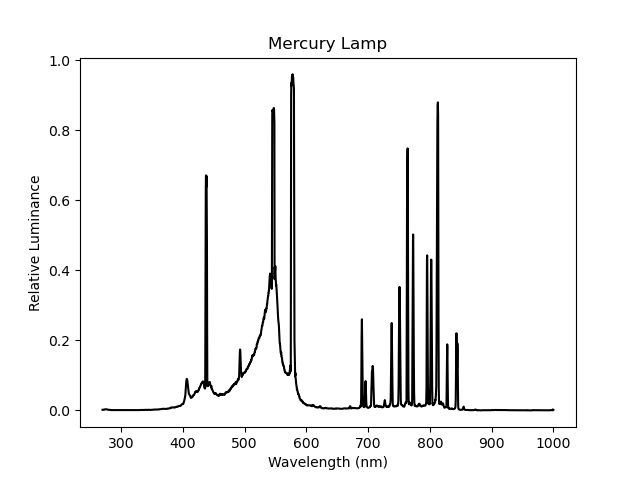
Figure/Mercury Lamp.png
