szl0834/DIY-Optical-Spectrometer/Figure/oh80jt0000001uvn.gif

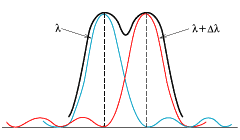
Figure/oh80jt0000001uvn.gif
