szl0834/DIY-Optical-Spectrometer/Figure/Sodium Lamp.png

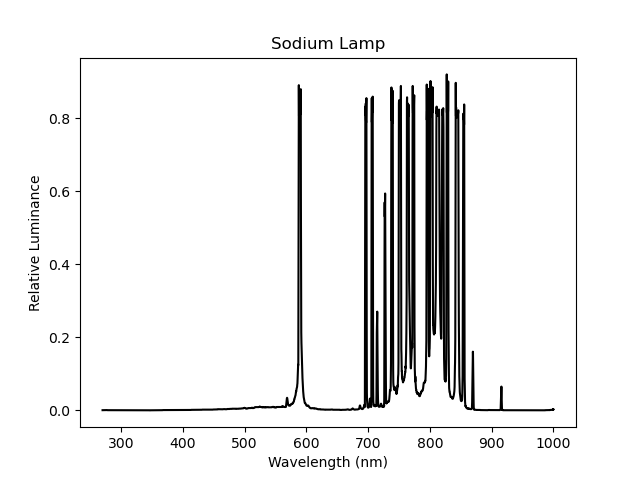
Figure/Sodium Lamp.png
