szl0834/DIY-Optical-Spectrometer/Figure/Sunlight.png

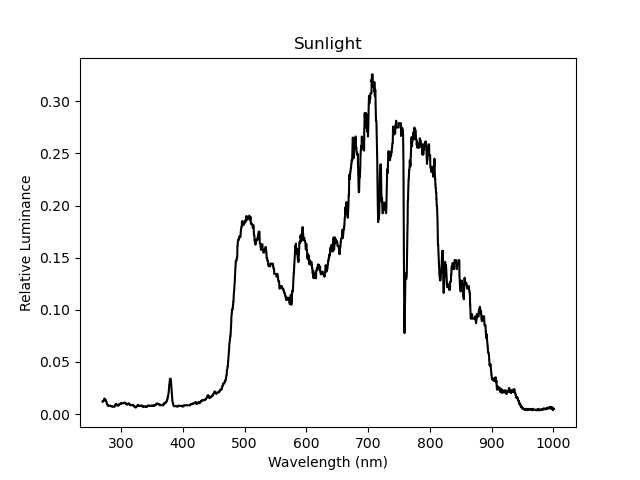
Figure/Sunlight.png
