szl0834/DIY-Optical-Spectrometer/FYP_Code/Figure_1.png

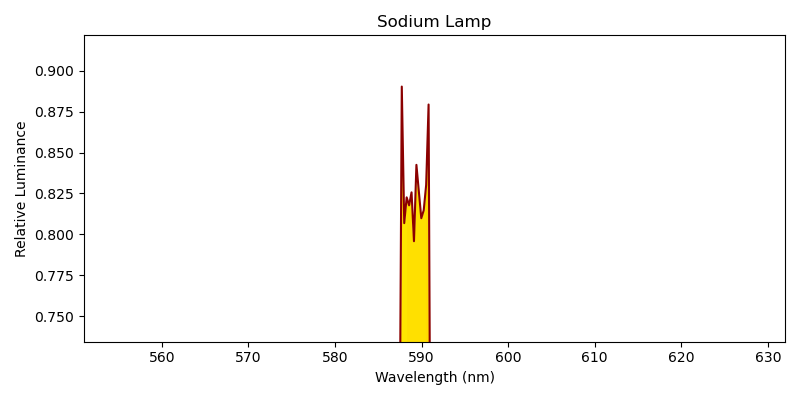
FYP_Code/Figure_1.png
