szl0834/DIY-Optical-Spectrometer/FYP_Code/FYP/Data/532laser.jpg

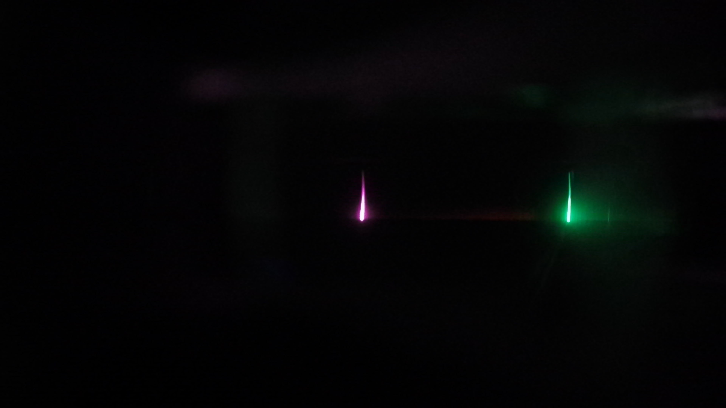
FYP_Code/FYP/Data/532laser.jpg
