szl0834/DIY-Optical-Spectrometer/FYP_Code/FYP/Data/FL.jpg

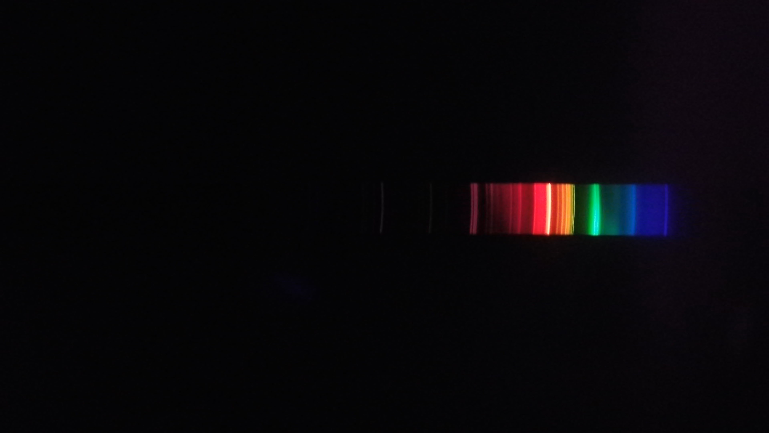
FYP_Code/FYP/Data/FL.jpg
