szl0834/DIY-Optical-Spectrometer/FYP_Code/FYP/Data/FL_F.jpg

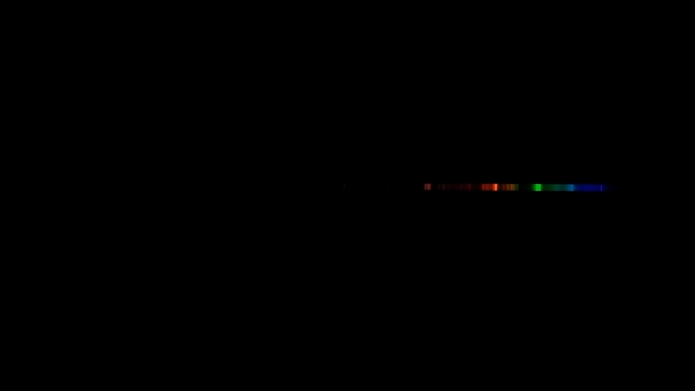
FYP_Code/FYP/Data/FL_F.jpg
