szl0834/DIY-Optical-Spectrometer/FYP_Code/FYP/Data/LED.jpg

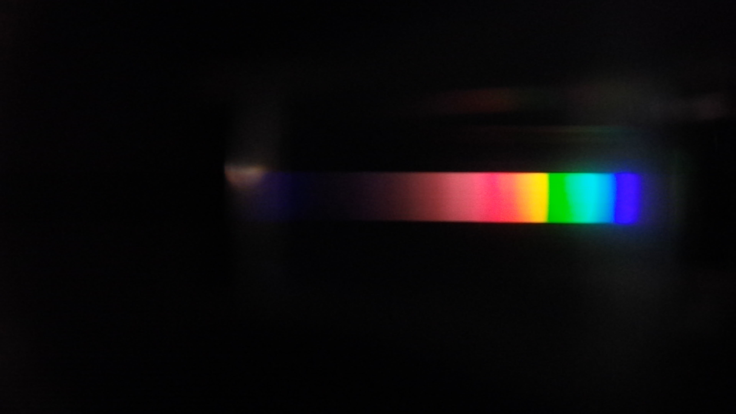
FYP_Code/FYP/Data/LED.jpg
