szl0834/DIY-Optical-Spectrometer/FYP_Code/FYP/Data/mercury_lamp.jpg

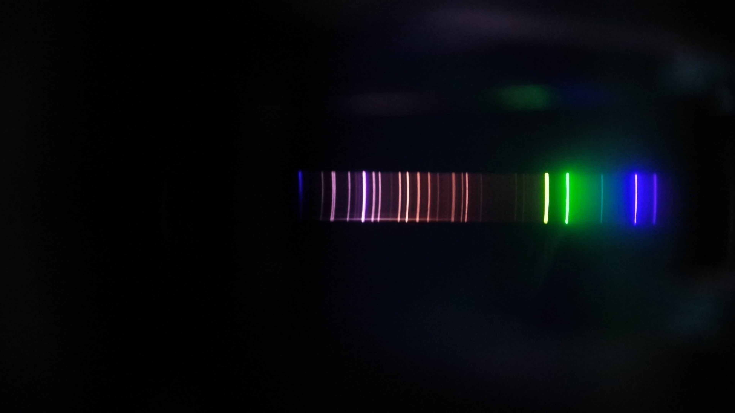
FYP_Code/FYP/Data/mercury_lamp.jpg
