szl0834/DIY-Optical-Spectrometer/FYP_Code/FYP/Data/mercury_lamp_F.jpg

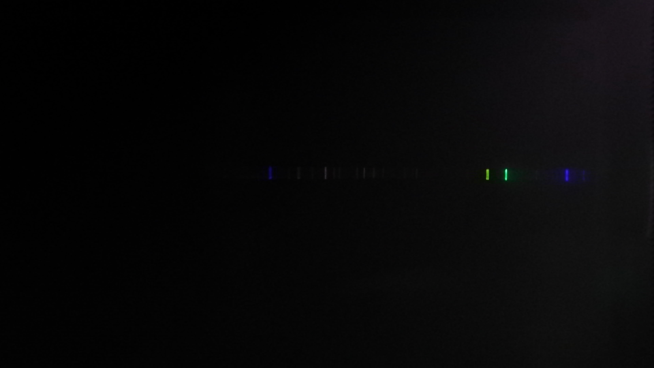
FYP_Code/FYP/Data/mercury_lamp_F.jpg
