szl0834/DIY-Optical-Spectrometer/FYP_Code/FYP/Data/RGB_LED.jpg

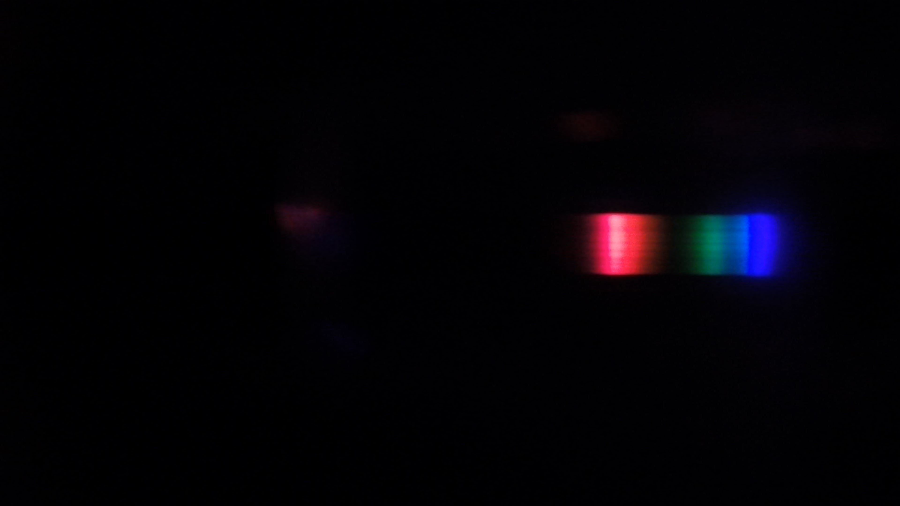
FYP_Code/FYP/Data/RGB_LED.jpg
