szl0834/DIY-Optical-Spectrometer/FYP_Code/FYP/Data/RGB_LED_RG.jpg

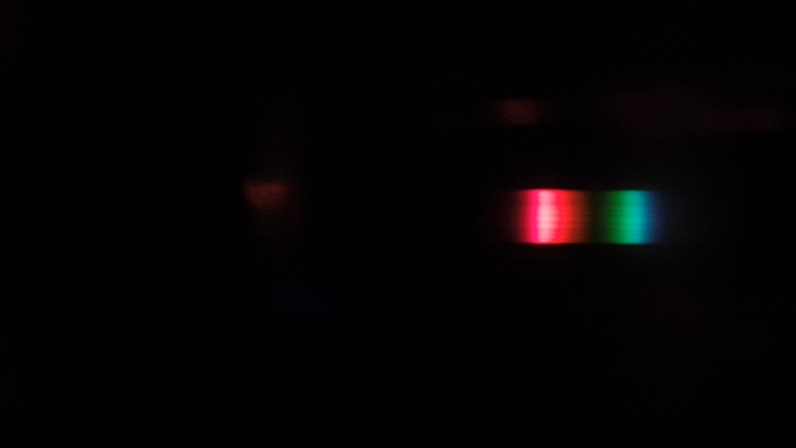
FYP_Code/FYP/Data/RGB_LED_RG.jpg
