szl0834/DIY-Optical-Spectrometer/FYP_Code/FYP/Data/sodium_lamp.jpg

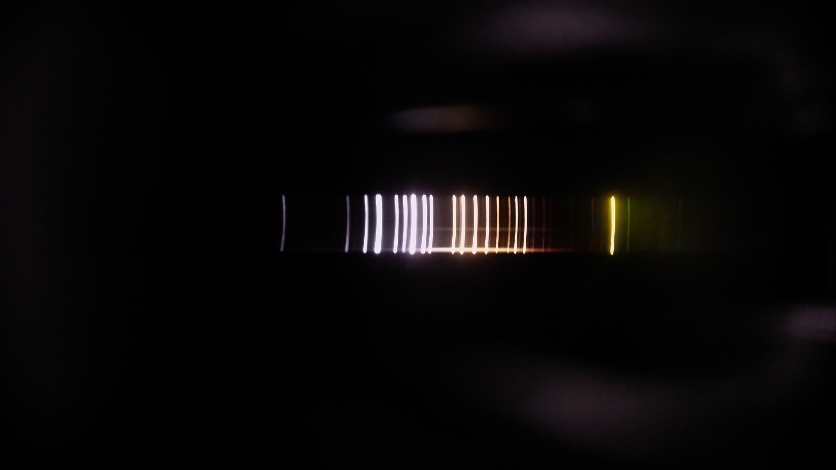
FYP_Code/FYP/Data/sodium_lamp.jpg
