szl0834/DIY-Optical-Spectrometer/FYP_Code/FYP/Data/sunlight.jpg

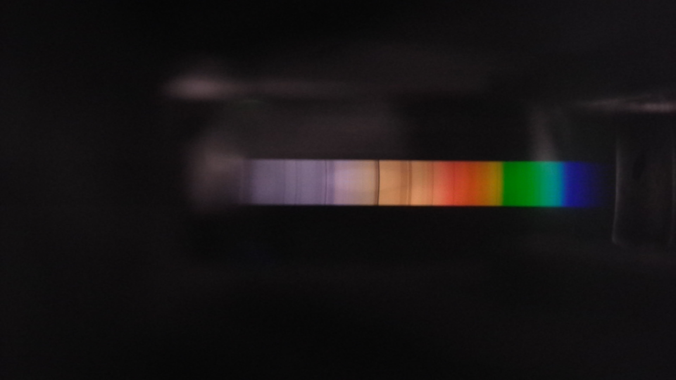
FYP_Code/FYP/Data/sunlight.jpg
