szl0834/DIY-Optical-Spectrometer/FYP_Code/spectrum.png

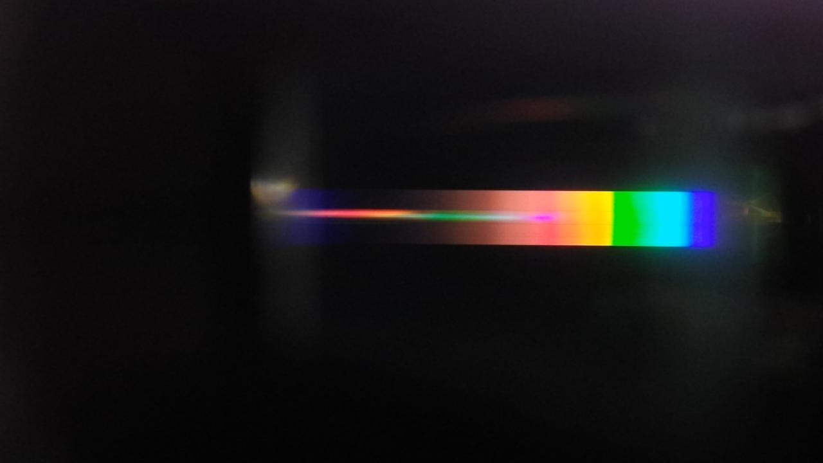
FYP_Code/spectrum.png
