szl0834/DIY-Optical-Spectrometer/Sundries/Project Outline1.png

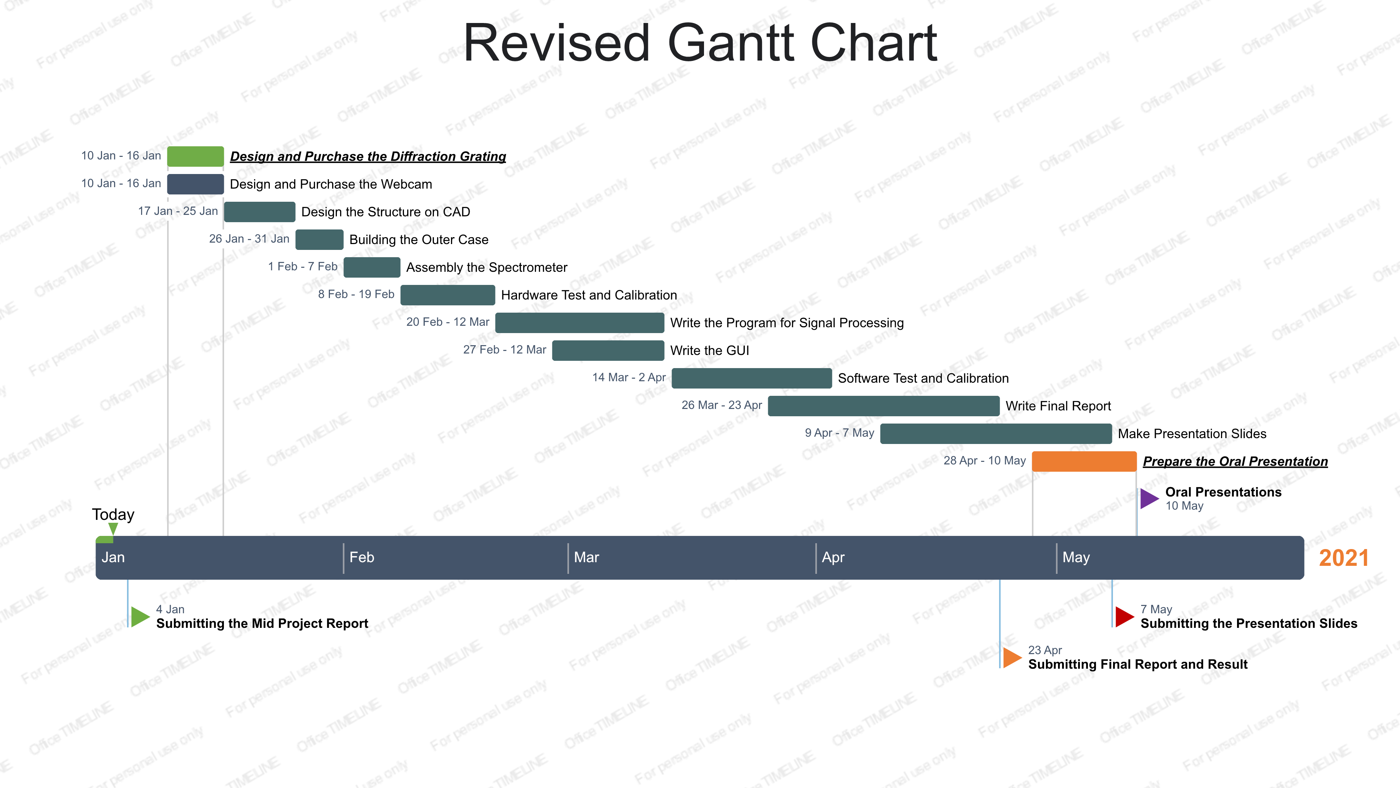
Sundries/Project Outline1.png
