szl0834/DIY-Optical-Spectrometer/Sundries/Project Outline.png

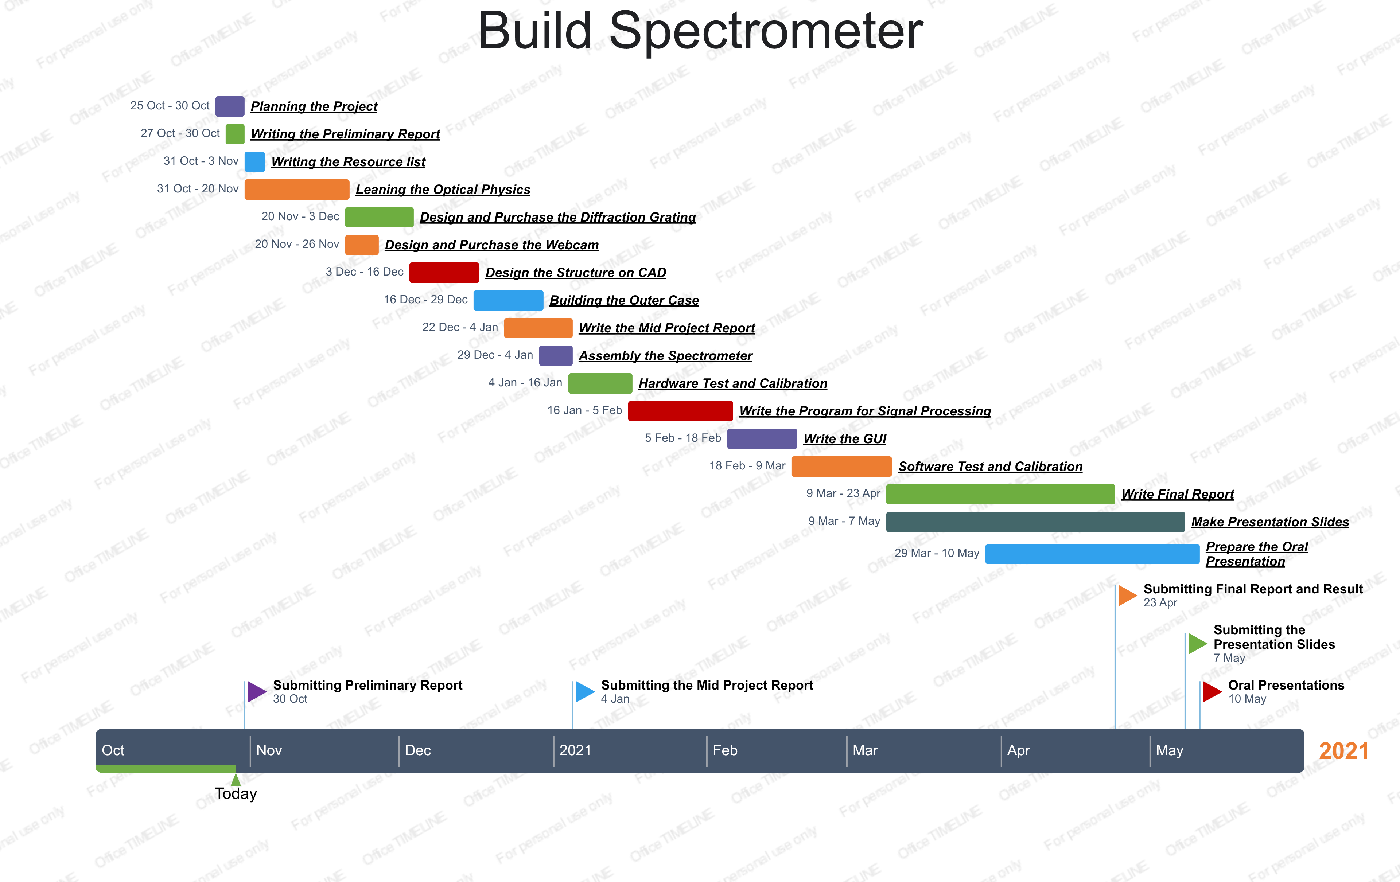
Sundries/Project Outline.png
