szl0834/DIY-Optical-Spectrometer/3D/3D_Model/assembly.SLDASM

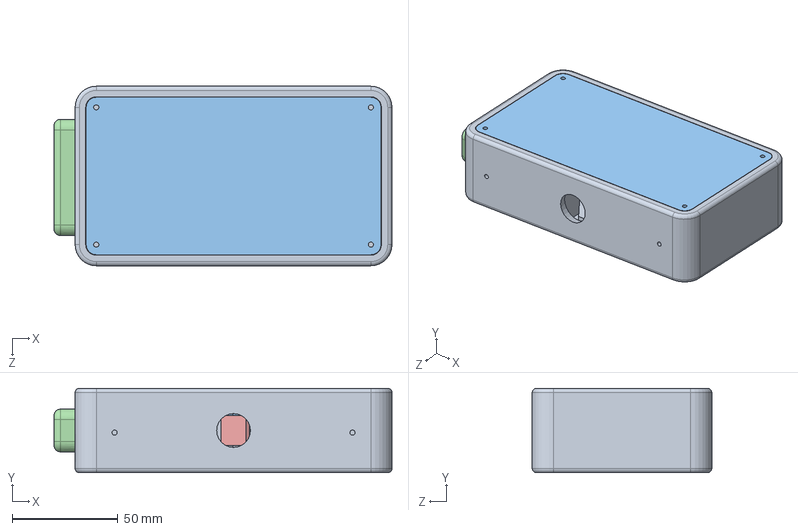
[picture p172: CAD file, 2021-06-10]
3D/3D_Model/assembly.SLDASM
160.0 x 40.0 x 85.0 mm
Bottel_2
collimator
Cover_type2
fiber_input
grating
slit_holder
