szl0834/DIY-Optical-Spectrometer/3D/3D_Model/collimator.SLDPRT

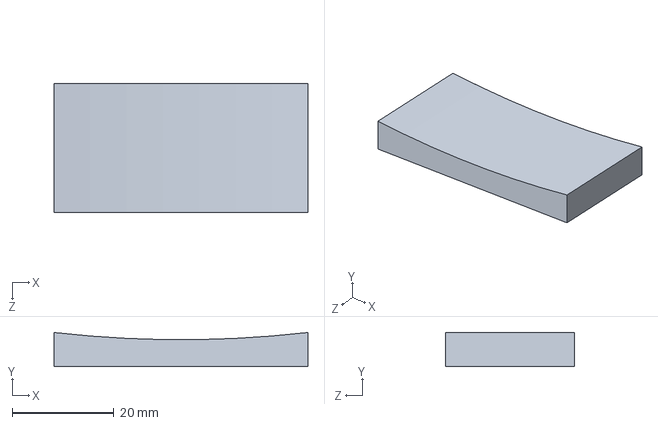
[picture p173: CAD file, 2021-06-10]
3D/3D_Model/collimator.SLDPRT
50.0 x 6.70 x 25.4 mm
