szl0834/DIY-Optical-Spectrometer/3D/3D_Model/cover.SLDPRT

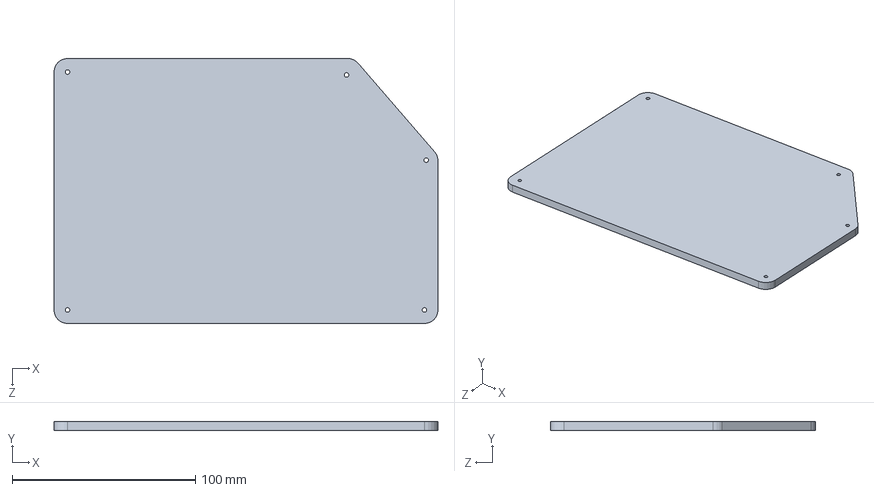
[picture p174: CAD file, 2021-06-10]
3D/3D_Model/cover.SLDPRT
209.8 x 5.00 x 144.8 mm
