szl0834/DIY-Optical-Spectrometer/3D/3D_Model/fiber_input.SLDPRT

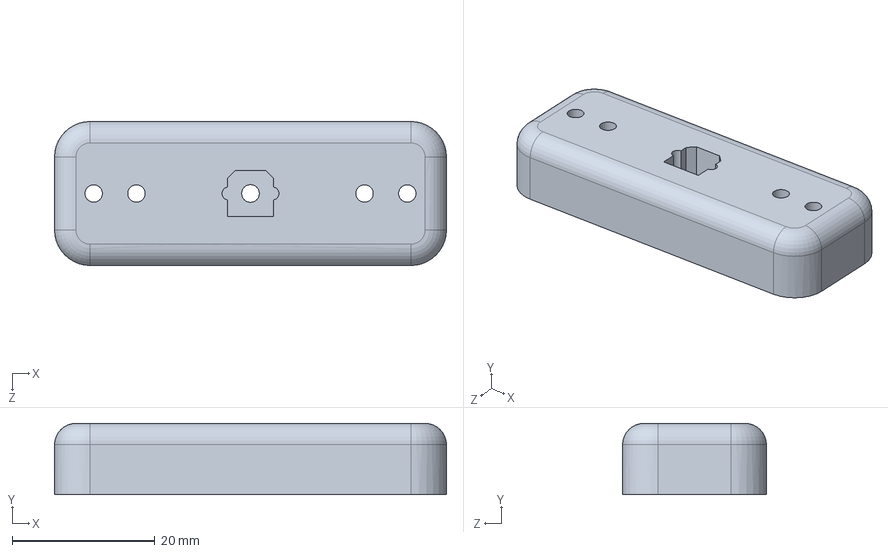
[picture p175: CAD file, 2021-06-10]
3D/3D_Model/fiber_input.SLDPRT
55.0 x 10.0 x 20.2 mm
