szl0834/DIY-Optical-Spectrometer/3D/3D_Model/Cover_type1.SLDPRT

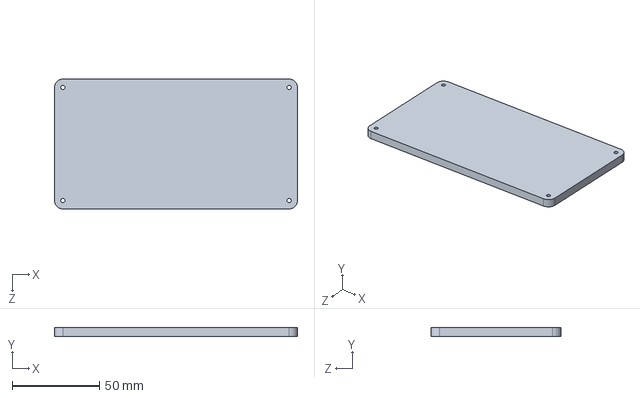
[picture p176: CAD file, 2021-06-10]
3D/3D_Model/Cover_type1.SLDPRT
139.6 x 5.00 x 74.6 mm
