szl0834/DIY-Optical-Spectrometer/3D/3D_Model/Bottel_2.SLDPRT

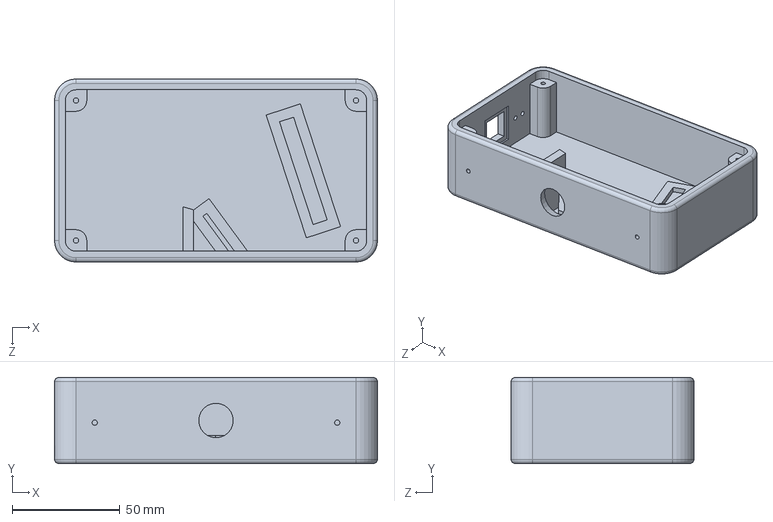
[picture p177: CAD file, 2021-06-10]
3D/3D_Model/Bottel_2.SLDPRT
150.0 x 40.0 x 85.0 mm
