szl0834/DIY-Optical-Spectrometer/3D/3D_Model/slit_holder.SLDPRT

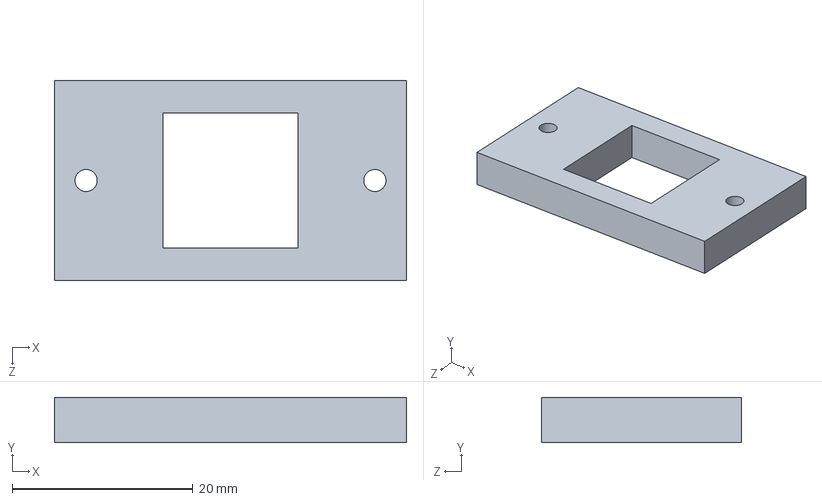
[picture p178: CAD file, 2021-06-10]
3D/3D_Model/slit_holder.SLDPRT
39.0 x 5.00 x 22.2 mm
