szl0834/DIY-Optical-Spectrometer/3D/3D_Model/bottel_1.SLDPRT

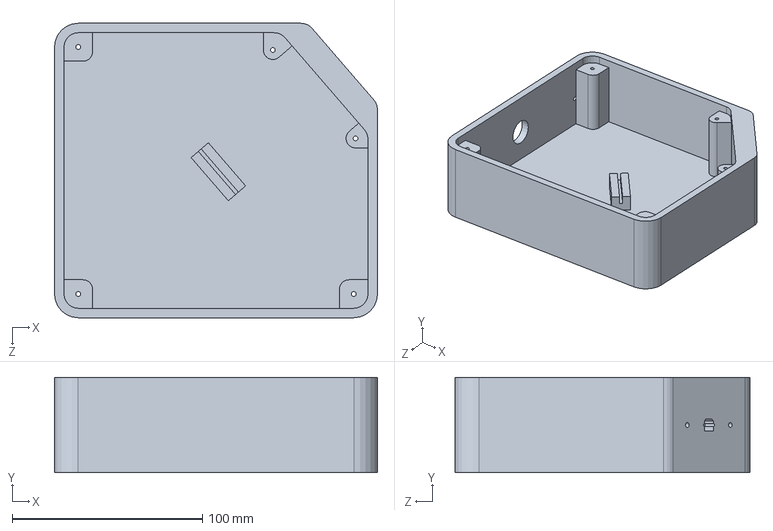
[picture p179: CAD file, 2021-06-10]
3D/3D_Model/bottel_1.SLDPRT
170.0 x 50.0 x 155.0 mm
