szl0834/DIY-Optical-Spectrometer/3D/3D_Model/grating.SLDPRT

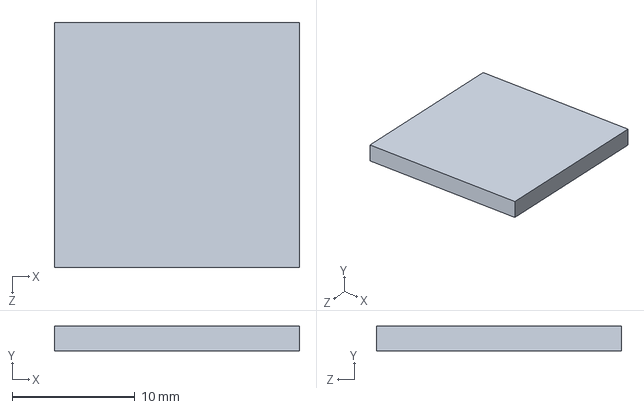
[picture p180: CAD file, 2021-06-10]
3D/3D_Model/grating.SLDPRT
20.0 x 2.00 x 20.0 mm
