szl0834/DIY-Optical-Spectrometer/3D/3D_Model/bottel.SLDPRT

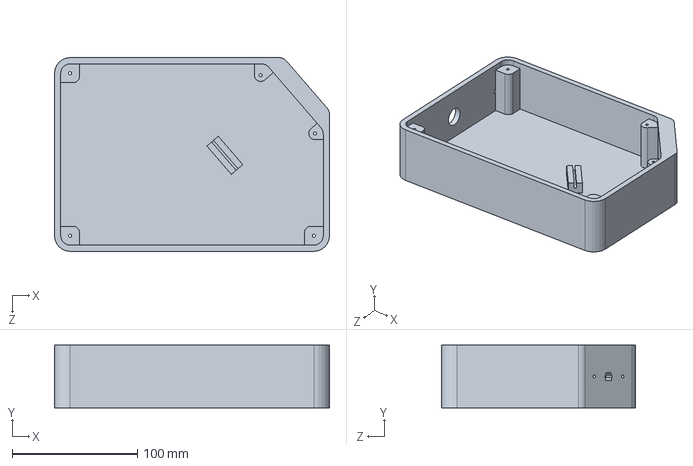
[picture p181: CAD file, 2021-06-10]
3D/3D_Model/bottel.SLDPRT
220.0 x 50.0 x 155.0 mm
