szl0834/DIY-Optical-Spectrometer/3D/3D_Model/Cover_type2.SLDPRT

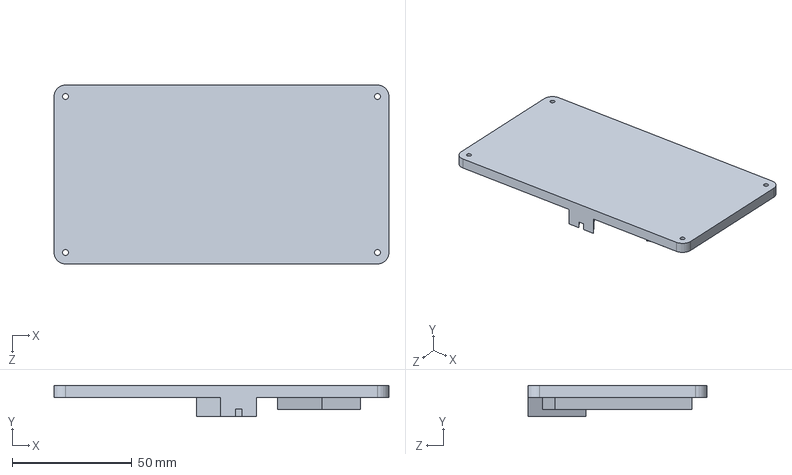
[picture p182: CAD file, 2021-06-10]
3D/3D_Model/Cover_type2.SLDPRT
139.6 x 13.0 x 74.6 mm
