szl0834/DIY-Optical-Spectrometer/(list of files, cad)

Other CAD files:
3D/3D_Printing/Bottel_2.STL
3D/3D_Printing/Cover_type2.STL
3D/3D_Printing/bottel.STL
3D/3D_Printing/bottel_1.STL
3D/3D_Printing/fiber_input.STL
3D/3D_Printing/slit_holder.STL
