szl0834/DIY-Optical-Spectrometer/Log Book/Logbook Cover Sheet.docx

Logbook

From: DD/MM/YYY To: DD/MM/YYY

Month | List the main activities (only few words per activity) | Interaction with the supervisor | | | Any other form of supervisory interaction (second supervisor, industry, fellows etc.)
| | Number of meetings | Mode of meeting (face- to-face, online e.g., Skype, WeChat etc.) | Number of emails exchanged
| 1. 2. 3. may expand, if needed
| 1. 2. 3. may expand, if needed
| 1. 2. 3. may expand, if needed
